eTextile/Synth/refs/publications/MOCO17-MusicSkin.pdf

# Musical Skin

## Fabric Interface for Expressive Music Control

## Maurin Donneaud

DataPaulee, France
maurin@datapaulee.org

## Cedric Honnet

DataPaulee, France
cedric@datapaulee.org

## Paul Strohmeier

HCC, University of Copenhagen, DK p.strohmeier@di.ku.dk

### ABSTRACT

We demonstrate a so, malleable fabric contoller. Aendees can use it to explore sounds, collaboratively create soundscapes and music. is so input device - Musical Skin - senses where it is touched and how much pressure is exerted on it. is is done using a method consisting entirely of fabric components. Using this textile matrix sensor, the performer’s role is changed from that of manipulating a rigid device to engaging with a malleable material. e sensor pushes the performer to explore how the motion of their body map to the sound, changing not only the performers experience but also engaging the audience beyond what typical electronic musical input devices would. In this extended abstract, we discuss the sensing mechanism and describe the installation we envision the musical skin to be used in.

### CCS CONCEPTS

- Human-centered computing → User interface toolkits ; • Applied computing → Sound and music computing ; Media arts ;

### KEYWORDS

Tangible Interfaces, Embodied Interaction, Musical Interface, e-Textile, So Circuits, On-Body Interaction

ACM Reference format:
Maurin Donneaud, Cedric Honnet, and Paul Strohmeier. 2017. Musical Skin. In Proceedings of International Conference on Movement and Computing, London, United Kingdom, June 2017 (MOCO’17), 2 pages.

### 1 INTRODUCTION

We present an installation using Musical Skins: fabric interfaces that users can freely manipulate to play music [2]. If draped over the body, interesting feedback modalities emerge. e users feel the tactile properties of the fabric in their ngertips, while at the same time feeling the pressure and taps of the ngers through their body. Additionally percussive hits, tones and pads ll the room with sound, leading to a multisensory experience involving the entire body. is fabric sensor is hand made (see gure 2), and designed for musical expression and aesthetics, explicitly opting for a playfull approach to technology over devices that turn us into productivity machines. Musical Skins can take on dierent roles, such as a drum kit to create distinct beats and one-shot sounds by

Permission to make digital or hard copies of part or all of this work for personal or classroom use is granted without fee provided that copies are not made or distributed for prot or commercial advantage and that copies bear this notice and the full citation on the rst page. Copyrights for third-party components of this work must be honored. For all other uses, contact the owner/author(s).
MOCO’17, London, United Kingdom
© 2017 Copyright held by the owner/author(s).

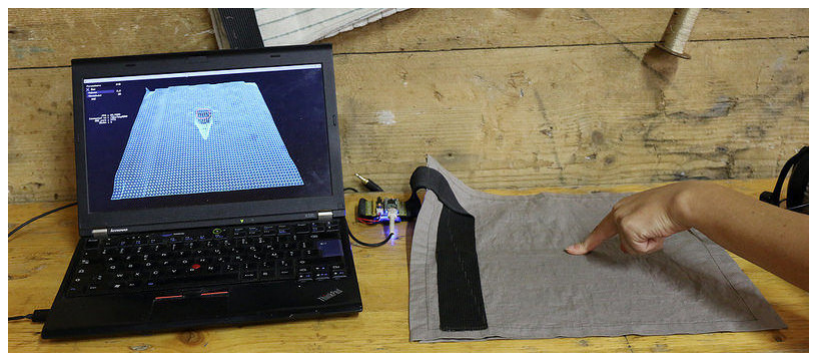
[picture p11: figure]

Figure 1: Visualization of the Musical Skin being touched.

tapping it, or a lead instrument to play modulated melodies on it, or polyphonic device for exploring harmonies, and soundscapes. Dierent instruments will be accessible to the visitors during the exhibit. As the sensor is very robust, no special training or instruction is required for participants.

### 2 RELATED WORK

Electronic textiles have recently received a signicant amount of attention with project Jacquard, however e-textiles and so circuitry have a much longer history. For example, Joanna Berzowska presented e-textile fashion in 2004 [1], her dresses retained a ’memory’ of intimate experiences of the wearer. Hannah Perner Wilson published an overview of so fabric sensors in 2009 [5] and along with Mika Satomi, they maintain an archive of electronic textile experimentations 1
. Similar resistive sensing solutions to ours are used as rapid-prototyping methods. Some of these methods have been documented by David Holman [4]. We use a layering technique demonstrated by Rachel Freire [3]. Our musical skins add additional expressive modalities over typical keyed input devices. is has also been explored by others, such as Seabord 2

, Linnstrument 3 or
Lambdoma 4

### 3 IMPLEMENTATION

is textile sensor was designed with open source, collaborative and DIY development in mind (see gure 2). e hardware and soware designs are freely available and documented at hp://eTextile.org.

### 3.1 Hardware

3.1.1 Textiles. e sensor consists of a grid of vertical and horizontal conductive textile strips (see gure 3), separated by a piezoelectric fabric. When the material is touched, the piezoelectrical

1hp://kobakant.at/DIY
2hp://www.needforkeys.com/blog/the-seaboard-grand-redening-the-keyboard 3hp://www.rogerlinndesign.com/linnstrument.html 4hp://www.lambdoma.com/keyboard.php

MOCO’17, June 2017, London, United Kingdom | Donneaud, Honnet and Strohmeier

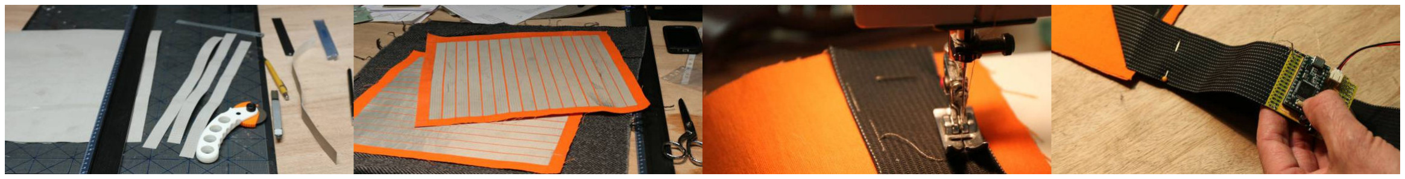
[picture p12: figure]

Figure 2: Steps to create the conductive layers and connect them to the microcontroller.

material is compressed, decreasing its resistance. e conductive fabric used is made by Stratex 5 but there are more aordable alternatives available. e piezoresistive textile used for now is made by Eeonyx 6
and has a resistance of 20K ohms per square. While the material is relatively expensive, it allows for detailed measurement range and a fairly good power consumption compared to other available resistive materials such as Velostat 7

3.1.2 Electronics. A simple voltage divider allows measuring this resistance, but we need a matrix to measure all the possible pressure points. is is done by sequentially pulling each power line high, and measured the voltage by column, in a nested loop. Figure 3 shows an overview of how a 4 x 4 variable resistor matrix is connected (note that our system has a 16 x 16 resolution).

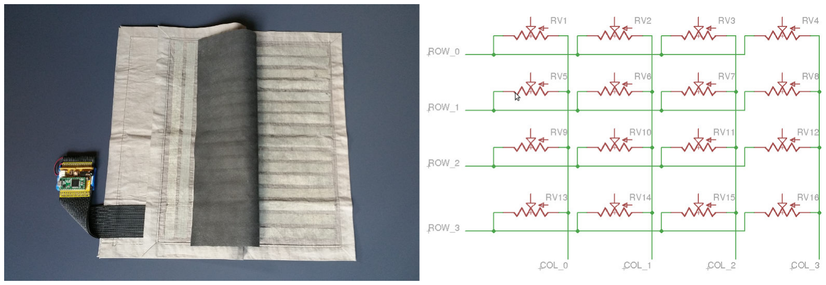
[picture p13: figure]

Figure 3: Le: the vertical and horizontal stripes of conductive fabric, and the resistive fabric in the middle (dark grey). Right: Illustration of a part of the variable ”resistor” matrix.

### 3.2 Soware

3.2.1 Microcontroller. We use a Teensy 3.X 8
to sample the voltages of the sensor. e noise oor is subtracted and the data is normalized, then sent as packets to a computer. Additionally, we use the analog output of the Teensy to allow generating audio without a computer (the board embeds everything needed to work on rechargeable baery).

3.2.2 Computer. When connected to a computer, the data is processed by a program made with OpenFrameworks.cc. We use blob detection algorithms from OpenCV.org to detect the size and locations of touch points. To improve the blob detection, we interpolate the data from 16 x 16 to 64 x 64. As we get a continuous pressure measure, this interpolation improves the resulting touch localization. Each blob’s center and pressure level is then sent to other applications using the OSC protocol. is enables the Musical

5hp://statex.de
6hp://eeonyx.com
7hp://www.lessemf.com/plastic.html 8hp://pjrc.com/teensy

Skin to control music applications 9 or interactive visualizations as will be demonstrated during the exhibition.

### 4 DEMO

e installation can be adopted to the constraints and opportunities of the space available to us. Visitors will discover that dierent instruments require dierent input behavior. e so malleable nature of the controller allows for interesting explorations not possible with conventional interfaces [2]. For example, while a single touch typically would trigger a single sound or drum hit, if the instrument is folded, visitors can create custom polyphonic soundscapes. Finally, this music controller allows to use our bodies
- or the bodies of others - as instruments: we can amplify body percussion with additional sounds, or we can hug each other to create soundscapes. As such expressive on-body input is novel, we believe that our demonstration will provide visitors with a valuable opportunity to improve their intuitive understanding of such technologies.

### 5 CONCLUSION

We propose an installation consisting of Musical Skins which can be used by visitors to control the environment in the form of adapting sound. e primary intent of the fabric instruments is for collaboratively making music while exploring shapes, materiality and bodies. is can be done by draping the fabric over objects, folding and deforming the fabric, or wearing it on the body. e e-textile itself is open source and improves over similar sensing applications both in terms of robustness and resolution.

### 6 ACKNOWLEDGMENT

is paper is based on a project by Maurin Donneaud [2] that dates back to 2005. is paper was supported by the European Research Council, grant no. 648785.

### REFERENCES

[1] Joanna Berzowska. 2004. Very Slowly Animating Textiles: Shimmering Flower. In ACM SIGGRAPH 2004 Sketches (SIGGRAPH ’04). ACM.
[2] Maurin Donneaud, Cedric Honnet, and Paul Strohmeier. 2017. Designing a Multi-Touch eTextile for Music Performances. In Proceedings of the 17th International Conference on New Interfaces for Musical Expression (NIME ’17).
[3] Rachel Freire, Cedric Honnet, and Paul Strohmeier. 2017. Second Skin: An Exploration of eTextile Stretch Circuits on the Body. In Proceedings of the Eleventh International Conference on Tangible, Embedded, and Embodied Interaction (TEI ’17). ACM, New York, NY, USA. DOI:hp://dx.doi.org/10.1145/3024969.3025054
[4] David Holman and Roel Vertegaal. 2011. TactileTape: Low-cost Touch Sensing on Curved Surfaces. In Proceedings of the 24th Annual ACM Symposium Adjunct on User Interface Soware and Technology (UIST ’11 Adjunct). ACM, 17–18.
[5] Hannah Perner-Wilson and Leah Buechley. 2010. Making Textile Sensors from Scratch. Proceedings of the Fourth International Conference on Tangible, Embedded, and Embodied Interaction (2010), 349–352.

9Available on hp://github.com/eTextile/Skins
