eTextile/Synth/docs/assets/img/synth_gitHub.png

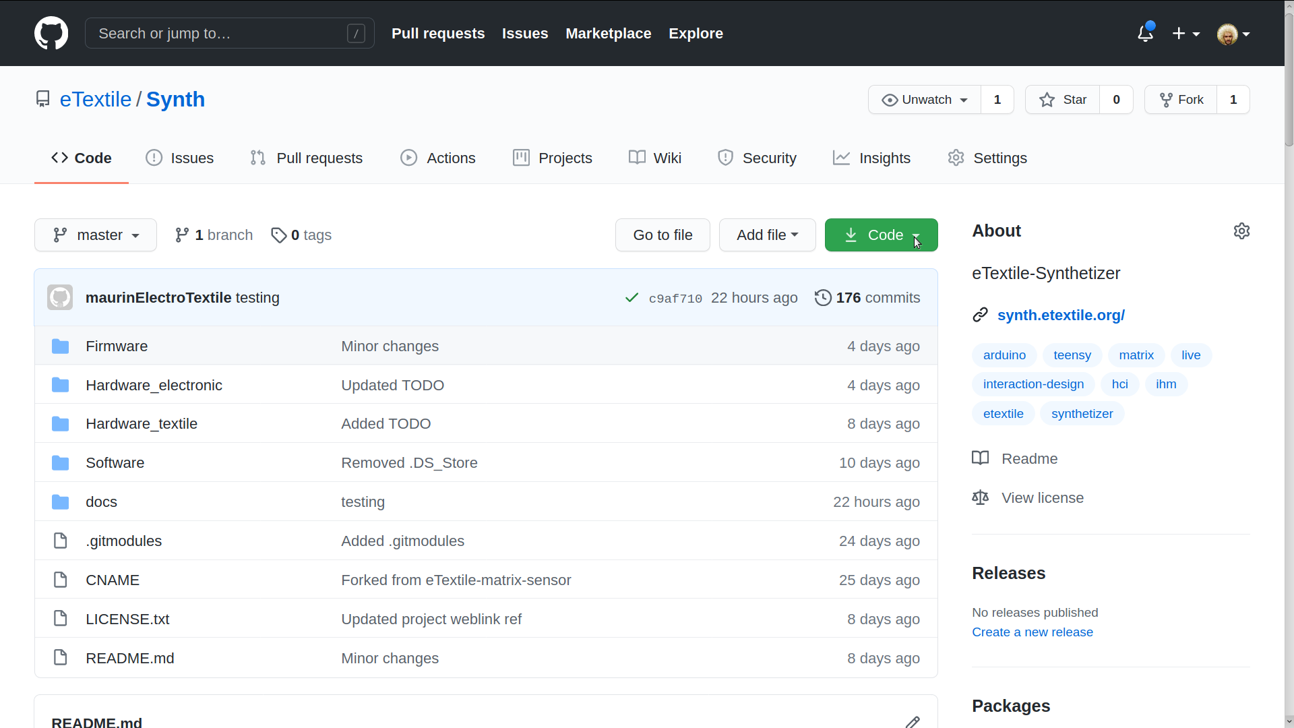
docs/assets/img/synth_gitHub.png
