eTextile/Synth/Hardware_electronic/docs/6N138.png

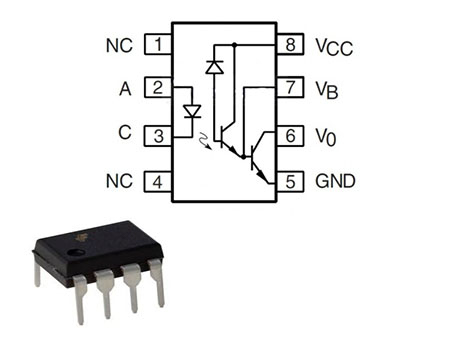
Hardware_electronic/docs/6N138.png
