eTextile/Synth/Hardware_textile/score_Johannes-Itten/800px-Farbkreis_Itten_1961.png

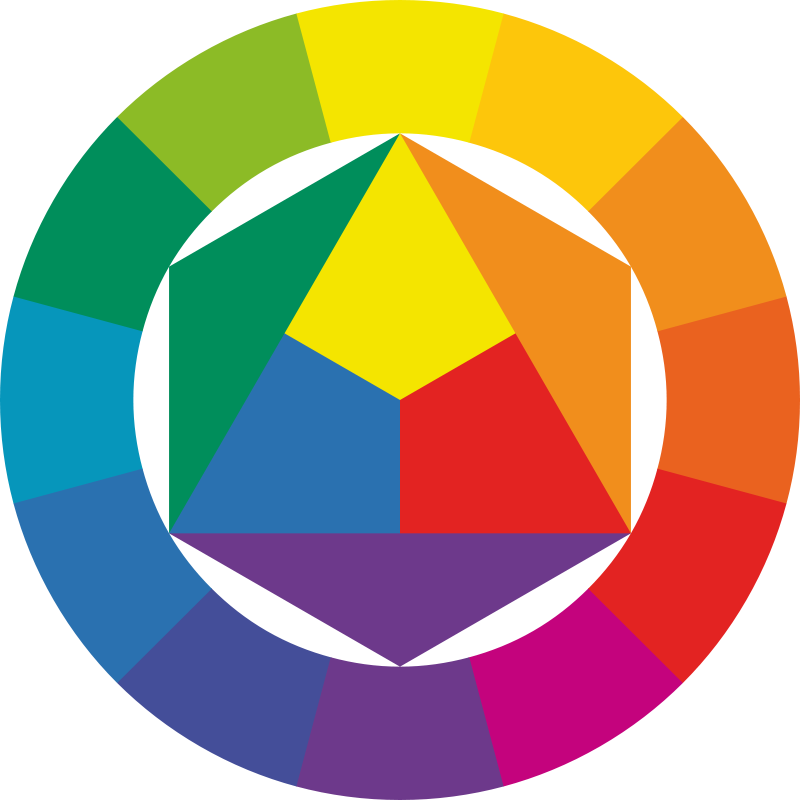
Hardware_textile/score_Johannes-Itten/800px-Farbkreis_Itten_1961.png
