eTextile/Synth/Hardware_electronic/docs/E256_LOGO.dxf

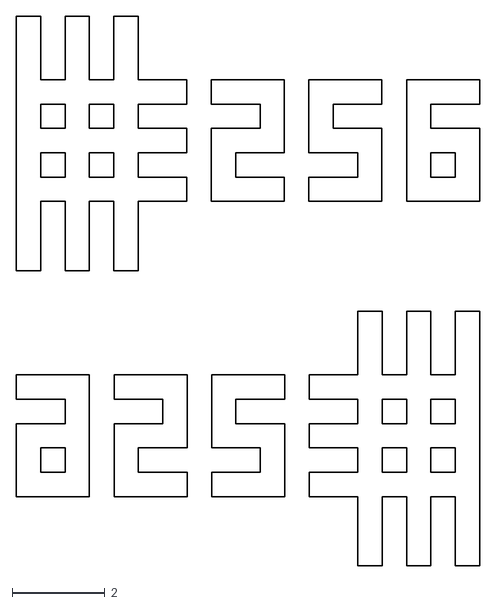
[picture p32: CAD file, 2021-01-04]
Hardware_electronic/docs/E256_LOGO.dxf
9.96 x 11.8
