eTextile/Synth/Hardware_electronic/kicad/e256_teensy4_0/docs/E256_truth_table.dxf

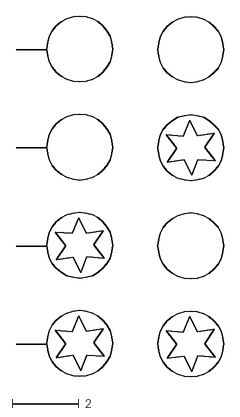
[picture p33: CAD file, 2021-01-04]
Hardware_electronic/kicad/e256_teensy4_0/docs/E256_truth_table.dxf
6.20 x 10.8
