eTextile/Synth/Hardware_electronic/kicad/e256_teensy4_0/docs/E256_polarity.dxf

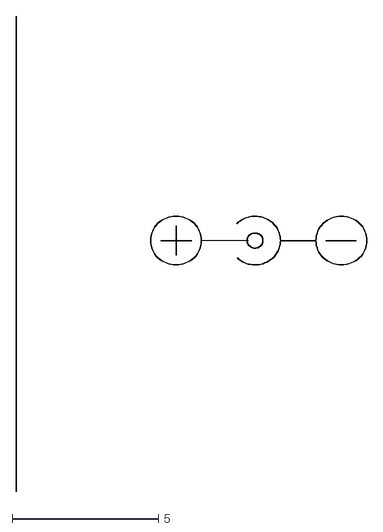
[picture p34: CAD file, 2021-01-04]
Hardware_electronic/kicad/e256_teensy4_0/docs/E256_polarity.dxf
12.0 x 16.3
