eTextile/Synth/Hardware_electronic/kicad/e256_teensy4_0/e256_teensy4_0.kicad_pcb

## KiCad design Hardware_electronic/kicad/e256_teensy4_0/e256_teensy4_0.kicad_pcb (2026-05-15)

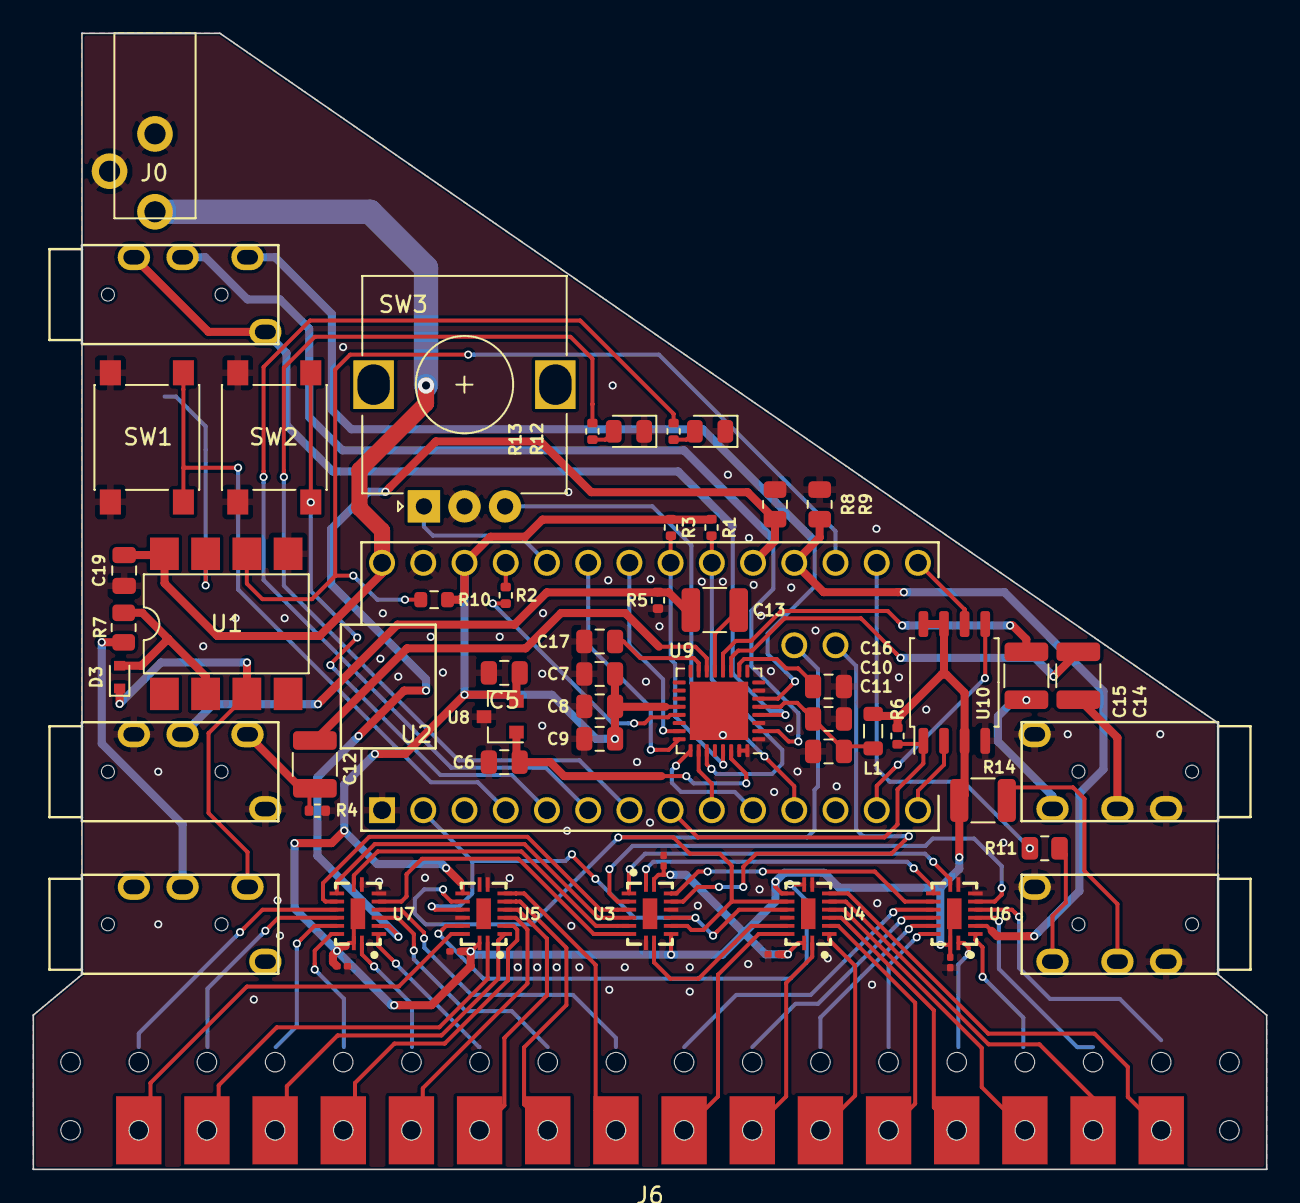
[picture p39: board e256_teensy4_0.kicad_pcb from above]

Board: 2 copper layers, 76.0 x 70.0 mm, 58 parts (1 on the bottom side), 93 nets.

Parts:
C1, C2, C3, C4, C18: 0.1uF 6.3V X5R; C_0201_0603Metric
C5, C6: 2.2uF_X7R; C_0805_2012Metric
C7, C10: 2.2uF; C_0805_2012Metric
C8, C9, C11, C16, C17, C19: 0.1uF; C_0805_2012Metric
C12, C13, C14, C15: 1uF; C_1210_3225Metric
D1, D2: LED; LED_0805_2012Metric
D3: 1N4148; D_SOD-523
J0: Conn_Coaxial_Power; BarrelJack-SMT-DC003_Horizontal
J1: MIDI_IN; PJ-320A
J2: MIDI_OUT; PJ-320A
J3: AUDIO_IN; PJ-320A
J4: AUDIO_OUT; PJ-320A
J5: LINE_OUT; PJ-320A
J6: e256_pad_16x16; e256_pad_16X16
L1: 600R; L_0805_2012Metric
R1, R3: 2.2K; R_0402_1005Metric
R2: 100R; R_0402_1005Metric
R4, R5: 100k; R_0402_1005Metric
R6: 10K; R_0402_1005Metric
R7: 220 Ohm; R_0805_2012Metric
R8, R9: 10K; R_0805_2012Metric
R10: 470 Ohm; R_0603_1608Metric
R11: 47 Ohm 1/8W; R_0805_2012Metric
R12, R13: 100 Ohm; R_0402_1005Metric
R14: 47 Ohm 1/3W; R_1210_3225Metric
R15: 10K; R_0805_2012Metric_Pad1.20x1.40mm_HandSolder
SW1, SW2: SW_Push; SW_SPST_PTS645
SW3: RotaryEncoder_Switch; RotaryEncoder_Alps_EC12E_Vertical_H20mm
U1: 6N138SM; 6N138SM_8-SMD
U2: Teensy4.0; Teensy40
U3, U4, U5: 74HC595BQ; DHVQFN-16-2.5X3.5MM
U6, U7: 74HC4051BQ; DHVQFN-16-2.5X3.5MM
U8: MCP1811A; SOT-23
U9: SGTL5000; QFN-32-1EP_5x5mm_P0.5mm_EP3.6x3.6mm
U10: W25Q128JVS; SOIC-8_5.23x5.23mm_P1.27mm

Connections:
+1V8: C6.1, U8.1, U9.30
+5V: C19.1, J0.1, U1.8, U2.33
/SGTL5000/filter_audio_3v3: C10.1, C11.1, L1.2, U9.5
ANALOG_0: R9.1, U2.23, U6.3
ANALOG_1: R8.1, U2.24, U7.3
BCLK: U2.28, U9.24
COL_0: J6.16, U4.7
COL_1: J6.17, U4.6
COL_2: J6.18, U4.5
COL_3: J6.19, U4.4
COL_4: J6.20, U4.3
COL_5: J6.21, U4.2
COL_6: J6.22, U4.1
COL_7: J6.23, U4.15
COL_8: J6.24, U5.7
COL_9: J6.25, U5.6
COL_10: J6.26, U5.5
COL_11: J6.27, U5.4
COL_12: J6.28, U5.3
COL_13: J6.29, U5.2
COL_14: J6.30, U5.1
COL_15: J6.31, U5.15
DS_B: U3.9, U4.14
DS_C: U4.9, U5.14
ENCODER_A: SW3.A, U2.29
ENCODER_B: SW3.B, U2.11
EN_A: U3.3, U6.6
EN_B: U3.7, U7.6
GND: C1.2, C2.2, C3.2, C4.2, C5.2, C6.2, C7.2, C8.2, C9.2, C10.2, C11.2, C16.2, C17.2, C18.2, C19.2, D1.1, D2.1, J0.2, J2.R2, J2.S, J3.R2, J3.S, J4.R2, J4.S, R4.1, R5.1, R8.2, R9.2, R15.2, SW1.2, SW2.2, SW3.C, U1.5, U2.1, U2.32, U3.8, U3.13, U4.8, U4.13, U5.8, U5.13, U6.7, U6.8, U7.7, U7.8, U8.3, U9.1, U9.3, U9.7, U9.31, U9.32, U9.33, U10.4
I2C_SCL_0: R3.2, U2.26, U9.29
I2C_SDA_0: R1.2, U2.25, U9.27
I2S_IN: U2.10, U9.25
I2S_OUT: U2.9, U9.26
LED_1: R12.1, U2.6
LED_2: R13.1, U2.7
LRCLK: U2.27, U9.23
MCLK: R2.2, U2.30
MEM_CS: R6.2, U2.8, U10.1
MEM_MISO: U2.14, U10.2
MEM_MOSI: U2.13, U10.5
MEM_SCK: U2.20, U10.6
MIDI_IN: R10.2, U1.6, U2.22
MIDI_OUT: R11.2, U2.21
unnamed: C12.1, U9.14
unnamed: C12.2, J3.T, R4.2
unnamed: C13.1, U9.13
unnamed: C13.2, J3.R1, R5.2
unnamed: C14.1, U9.11
unnamed: C14.2, J4.R1
unnamed: C15.1, U9.12
unnamed: C15.2, J4.T
unnamed: C16.1, U9.10
unnamed: C17.1, U9.15
unnamed: D1.2, R13.2
unnamed: D2.2, R12.2
unnamed: D3.1, J1.T, U1.3
unnamed: D3.2, R7.1, U1.2
unnamed: J1.R1, R7.2
unnamed: J2.R1, R14.2
unnamed: J2.T, R11.1
unnamed: J5.R1, U9.2
unnamed: J5.R2, J5.S, U9.4
unnamed: J5.T, U9.6
unnamed: R2.1, U9.21
unnamed: R15.1, U1.7
ROW_0: J6.0, U6.5
ROW_1: J6.1, U6.4
ROW_2: J6.2, U6.2
ROW_3: J6.3, U6.1
ROW_4: J6.4, U6.15
ROW_5: J6.5, U6.14
ROW_6: J6.6, U6.13
ROW_7: J6.7, U6.12
ROW_8: J6.8, U7.5
ROW_9: J6.9, U7.4
ROW_10: J6.10, U7.2
ROW_11: J6.11, U7.1
ROW_12: J6.12, U7.15
ROW_13: J6.13, U7.14
ROW_14: J6.14, U7.13
ROW_15: J6.15, U7.12
S0_A: U3.15, U6.11
S0_B: U3.4, U7.11
S1_A: U3.1, U6.10
S1_B: U3.5, U7.10
S2_A: U3.2, U6.9
S2_B: U3.6, U7.9
SHIFT_OUT_CS: U2.2, U3.12, U4.12, U5.12
SHIFT_OUT_MOSI: U2.37, U3.14
SHIFT_OUT_SCK: U2.38, U3.11, U4.11, U5.11
SWITCH_A: SW1.1, U2.4
SWITCH_B: SW2.1, U2.5
VCC: C1.1, C2.1, C3.1, C4.1, C5.1, C7.1, C8.1, C9.1, C18.1, L1.1, R1.1, R3.1, R6.1, R10.1, R14.1, U2.31, U3.10, U3.16, U4.10, U4.16, U5.10, U5.16, U6.16, U6.EP, U7.16, U7.EP, U8.2, U9.20, U10.3, U10.7, U10.8
