eTextile/Synth/Firmware/src/config.cpp

/*
  This file is part of the eTextile-Synthesizer project - https://synth.eTextile.org
  Copyright (c) 2014- Maurin Donneaud <maurin@etextile.org>
  This work is licensed under Creative Commons Attribution-ShareAlike 4.0 International license, see the LICENSE file for details.
*/

#include <ArduinoJson.h>
#include <SerialFlash.h>
#include <Bounce2.h>

#include "config.h"
#include "scan.h"
#include "interp.h"
#include "usb_midi_io.h"
#include "hardware_midi_io.h"
#include "allocate.h"
#include "mapping.h"

#include "mapp_switch.h"
#include "mapp_slider.h"
#include "mapp_touchpad.h"
#include "mapp_knob.h"
#include "mapp_polygon.h"
#include "mapp_grid.h"

Bounce BUTTON_L = Bounce();
Bounce BUTTON_R = Bounce();

const char* get_mode_name(mode_code_t code) {
  const char* char_code = NULL;
  switch (code) {
    case PENDING_MODE: char_code = "PENDING_MODE"; break;
    case SYNC_MODE: char_code = "SYNC_MODE"; break;
    case CALIBRATE_MODE: char_code = "CALIBRATE_MODE"; break;
    case MATRIX_RAW_MODE: char_code = "MATRIX_RAW_MODE"; break;
    case MATRIX_INTERP_MODE: char_code = "MATRIX_INTERP_MODE"; break;
    case MAPPING_MODE: char_code = "MAPPING_MODE"; break;
    case EDIT_MODE: char_code = "EDIT_MODE"; break;
    case THROUGH_MODE: char_code = "THROUGH_MODE"; break;
    case PLAY_MODE: char_code = "PLAY_MODE"; break;
    case ALLOCATE_MODE: char_code = "ALLOCATE_MODE"; break;
    case UPLOAD_MODE: char_code = "UPLOAD_MODE"; break;
    case APPLY_MODE: char_code = "APPLY_MODE"; break;
    case WRITE_MODE: char_code = "WRITE_MODE"; break;
    case LOAD_MODE: char_code = "LOAD_MODE"; break;
    case FETCH_MODE: char_code = "FETCH_MODE"; break;
    case STANDALONE_MODE: char_code = "STANDALONE_MODE"; break;
    case USB_INTERFACE_MODE: char_code = "USB_INTERFACE_MODE"; break;
    case ERROR_MODE: char_code = "ERROR_MODE"; break;
    case BOOTLOADER_MODE: char_code = "BOOTLOADER_MODE"; break;
  }
  return char_code;
};

const char* get_verbosity_name(verbosity_code_t code) {
  const char* char_code = NULL;
  switch (code) {
    case PENDING_MODE_DONE: char_code = "PENDING_MODE_DONE"; break;
    case SYNC_MODE_DONE: char_code = "SYNC_MODE_DONE"; break;
    case CALIBRATE_MODE_DONE: char_code = "CALIBRATE_MODE_DONE"; break;
    case MATRIX_RAW_MODE_DONE: char_code = "MATRIX_RAW_MODE_DONE"; break;
    case MATRIX_INTERP_MODE_DONE: char_code = "MATRIX_INTERP_MODE_DONE"; break;
    case MAPPING_MODE_DONE: char_code = "MAPPING_MODE_DONE"; break;
    case EDIT_MODE_DONE: char_code = "EDIT_MODE_DONE"; break;
    case THROUGH_MODE_DONE: char_code = "THROUGH_MODE_DONE"; break;
    case PLAY_MODE_DONE: char_code = "PLAY_MODE_DONE"; break;
    case ALLOCATE_MODE_DONE: char_code = "ALLOCATE_MODE_DONE"; break;
    case ALLOCATE_DONE: char_code = "ALLOCATE_DONE"; break;
    case UPLOAD_MODE_DONE: char_code = "UPLOAD_MODE_DONE"; break;
    case UPLOAD_DONE: char_code = "UPLOAD_MODE_DONE"; break;
    case CONFIG_APPLY_DONE: char_code = "CONFIG_APPLY_DONE"; break;
    case WRITE_MODE_DONE: char_code = "WRITE_MODE_DONE"; break;
    case LOAD_MODE_DONE: char_code = "LOAD_MODE_DONE"; break;
    case FETCH_MODE_DONE: char_code = "FETCH_MODE_DONE"; break;
    case STANDALONE_MODE_DONE: char_code = "STANDALONE_MODE_DONE"; break;
    case USB_INTERFACE_MODE_DONE: char_code = "USB_INTERFACE_MODE_DONE"; break;
    case DONE_ACTION: char_code = "DONE_ACTION"; break;
  }
  return char_code;
};

const char* get_level_name(level_code_t code) {
  const char* char_code = NULL;
  switch (code) {
    case THRESHOLD: char_code = "THRESHOLD"; break;
    case SIG_IN: char_code = "SIG_IN"; break;
    case SIG_OUT: char_code = "SIG_OUT"; break;
    case LINE_OUT: char_code = "LINE_OUT"; break;
  }
  return char_code;
};

const char* get_error_name(error_code_t code) {
  const char* char_code = NULL;
  switch (code) {
    case CONFIG_FILE_MISSING: char_code = "CONFIG_FILE_MISSING"; break;
    case CONNECTING_FLASH: char_code = "CONNECTING_FLASH"; break;
    case FLASH_FULL: char_code = "FLASH_FULL"; break;
    case FILE_TO_BIG: char_code = "FILE_TO_BIG"; break;
    case NO_CONFIG_FILE: char_code = "NO_CONFIG_FILE"; break;
    case WHILE_OPEN_FLASH_FILE: char_code = "WHILE_OPEN_FLASH_FILE"; break;
    case USBMIDI_CONFIG_LOAD_FAILED: char_code = "USBMIDI_CONFIG_LOAD_FAILED"; break;
    case FLASH_CONFIG_LOAD_FAILED: char_code = "FLASH_CONFIG_LOAD_FAILED"; break;
    case FLASH_CONFIG_WRITE_FAILED: char_code = "FLASH_CONFIG_WRITE_FAILED"; break;
    case CONFIG_APPLY_FAILED: char_code = "CONFIG_APPLY_FAILED"; break;
    case UNKNOWN_SYSEX: char_code = "UNKNOWN_SYSEX"; break;
    case TOO_MANY_BLOBS: char_code = "TOO_MANY_BLOBS"; break;
    case TOO_MANY_TOUCHS: char_code = "TOO_MANY_TOUCHS"; break;
  }
  return char_code;
};

e256_mode_t e256_m[19] = {
  {{HIGH, LOW, false}, 50, 50, true},     // [0] PENDING_MODE
  {{HIGH, LOW, false}, 500, 500, true},   // [1] SYNC_MODE
  {{HIGH, LOW, false}, 15, 15, true},     // [2] CALIBRATE_MODE
  {{HIGH, HIGH, false}, 200, 200, true},  // [3] MATRIX_RAW_MODE
  {{HIGH, HIGH, false}, 400, 400, true},  // [4] MATRIX_INTERP_MODE
  {{HIGH, HIGH, false}, 500, 500, true},  // [5] MAPPING_MODE
  {{HIGH, LOW, false}, 1000, 50, true},   // [6] EDIT_MODE
  {{HIGH, LOW, false}, 1500, 500, true},  // [7] THROUGH_MODE
  {{HIGH, LOW, false}, 50, 1000, true},   // [8] PLAY_MODE
  {{HIGH, LOW, false}, 1000, 1000, true}, // [9] ALLOCATE_MODE
  {{HIGH, LOW, false}, 1000, 1000, true}, // [10] UPLOAD_MODE
  {{HIGH, LOW, false}, 1000, 1000, true}, // [11] APPLY_MODE
  {{HIGH, LOW, false}, 1000, 1000, true}, // [12] WRITE_MODE
  {{HIGH, LOW, false}, 1000, 1000, true}, // [13] LOAD_MODE
  {{HIGH, LOW, false}, 1000, 1000, true}, // [14] FETCH_MODE
  {{LOW, HIGH, false}, 2000, 2000, true}, // [15] STANDALONE_MODE
  {{LOW, HIGH, false}, 100, 100, true},   // [16] USB_INTERFACE_MODE
  {{HIGH, HIGH, false}, 5, 5, true},      // [17] ERROR_MODE
  {{HIGH, HIGH, false}, 100, 100, true}  // [18] BOOTLOADER_MODE
};


// The E256 built-in encoder is used to adjust levels
Encoder e256_e(ENCODER_PIN_A, ENCODER_PIN_B);

// The levels below can be selected using E256 built-in right switche
level_t e256_l[4] = {
  {{HIGH, HIGH, false}, 2, 50, 2, false},  // [0] THRESHOLD
  {{HIGH, LOW, false}, 1, 31, 17, false},  // [1] SIG_IN
  {{LOW, HIGH, false}, 13, 31, 29, false}, // [2] SIG_OUT
  {{LOW, LOW, false}, 2, 60, 3, false}     // [3] LINE_OUT
};

control_t e256_ctr = {
  &e256_e,    // encoder_ptr
  &e256_m[0], // modes_ptr
  &e256_l[0]  // levels_ptr
};

mode_code_t e256_current_mode = PENDING_MODE;
level_code_t e256_current_level = THRESHOLD;

verbosity_code_t e256_verbosity_code;
error_code_t e256_error_code;

uint8_t* flash_config_ptr = NULL;
size_t flash_config_size = 0;

// Her it should not compile if you didn't install the library
// [Bounce2]: https://github.com/thomasfredericks/Bounce2
// https://www.pjrc.com/teensy/interrupts.html
// https://github.com/khoih-prog/Teensy_TimerInterrupt/blob/main/examples/SwitchDebounce/SwitchDebounce.ino
static void setup_buttons(void) {
  BUTTON_L.attach(BUTTON_PIN_L, INPUT_PULLUP);  // Attach the debouncer to a pin with INPUT_PULLUP mode
  BUTTON_R.attach(BUTTON_PIN_R, INPUT_PULLUP);  // Attach the debouncer to a pin with INPUT_PULLUP mode
  BUTTON_L.interval(25);                        // Debounce interval of 25 millis
  BUTTON_R.interval(25);                        // Debounce interval of 25 millis
};

void setup_leds(void* ptr) {
  leds_t* leds_ptr = (leds_t*)ptr;
  pinMode(LED_PIN_D1, OUTPUT);
  pinMode(LED_PIN_D2, OUTPUT);
  digitalWrite(LED_PIN_D1, leds_ptr->D1);
  digitalWrite(LED_PIN_D2, leds_ptr->D2);
};

void blink(uint8_t iter, uint16_t delay_time) {
  for (uint8_t i = 0; i<iter; i++){
    digitalWrite(LED_PIN_D1, HIGH);
    digitalWrite(LED_PIN_D2, HIGH);
    delay(delay_time);
    digitalWrite(LED_PIN_D1, LOW);
    digitalWrite(LED_PIN_D2, LOW);
    delay(delay_time);
  }
};

void set_mode(mode_code_t mode) {
  e256_ctr.modes[(uint8_t)e256_current_mode].leds.update = false;
  e256_ctr.levels[(uint8_t)e256_current_level].leds.update = false;
  setup_leds(&e256_ctr.modes[(uint8_t)mode]);
  e256_ctr.modes[(uint8_t)mode].leds.update = true;
  //e256_last_mode = e256_current_mode;
  e256_current_mode = mode;
  #if defined(USB_MIDI_SERIAL) && defined(DEBUG_MODES)
    Serial.printf("\nMODE:\t%s", get_mode_name(mode));
  #endif
};

void set_level(level_code_t level, uint8_t value) {
  e256_ctr.modes[(uint8_t)e256_current_mode].leds.update = false;
  e256_ctr.encoder->write(value << 2);
  setup_leds(&e256_ctr.levels[(uint8_t)level]);
  e256_ctr.levels[(uint8_t)level].update = true;
  e256_current_level = level;
  #if defined(USB_MIDI_SERIAL) && defined(DEBUG_LEVELS)
    Serial.printf("\n%s:\t%d", get_level_name(level), value);
  #endif
};

static bool flash_file(const char* fileName, uint8_t* data_ptr, uint16_t size) {
  if (sysEx_data_length != 0) {
    SerialFlash.wakeup();
    while (!SerialFlash.ready());
    if (SerialFlash.exists(fileName)) {
      SerialFlash.remove(fileName);
    }
    // Create a new file and open it for writing
    SerialFlashFile tmpFile;
    if (SerialFlash.create(fileName, size)) {
      tmpFile = SerialFlash.open(fileName);
      if (!tmpFile){
        usb_midi_send_sysex_err((uint8_t)WHILE_OPEN_FLASH_FILE);
        return false;
      }
    }
    else {
      usb_midi_send_sysex_err((uint8_t)FLASH_FULL);
      return false;
    }
    if (sysEx_data_length < FLASH_CHIP_SIZE) {
      tmpFile.write(data_ptr, size);
      tmpFile.close();
      SerialFlash.sleep();
      return true;
    }
    else {
      usb_midi_send_sysex_err((uint8_t)FILE_TO_BIG);
      return false;
    }
  }
  return false;
};

// Selec the current mode and perform the matrix sensor calibration 
static void update_buttons(void) {
  BUTTON_L.update();
  BUTTON_R.update();
  // ACTION: BUTTON_L short pressure
  // FONCTION: CALIBRATE THE SENSOR MATRIX
  if (BUTTON_L.rose() && BUTTON_L.previousDuration() < LONG_HOLD) {
    matrix_calibrate();
    blink(10, 50);
  }

  // ACTION: BUTTON_L long pressure
  // FONCTION: save the mapping config file to the permanent flash memory
  if (BUTTON_L.rose() && BUTTON_L.previousDuration() > LONG_HOLD) {
    if (e256_current_mode == STANDALONE_MODE) return;
    if (sysEx_data_length > 0) {
      if (flash_file("config.json", sysEx_data_ptr, sysEx_data_length)){
        usb_midi_send_sysex_ack((uint8_t)WRITE_MODE_DONE);
      }
      else {
        usb_midi_send_sysex_err((uint8_t)FLASH_CONFIG_WRITE_FAILED);
        //set_mode(ERROR_MODE);
      }
    }
  }

  // ACTION: BUTTON_R long pressure
  // FONCTION: PENDING_MODE (waiting for mode)
  // LEDs: blink slowly (500ms) alternately
  if (BUTTON_R.rose() && BUTTON_R.previousDuration() > LONG_HOLD) {
    set_mode(PENDING_MODE);
    boot_time = millis();
  }

  // ACTION: BUTTON_R short pressure
  // FONCTION: SELECT_LEVEL
  // levels[0] = THRESHOLD
  // levels[1] = SIG_IN
  // levels[2] = SIG_OUT
  // levels[3] = LINE_OUT
  if (BUTTON_R.rose() && BUTTON_R.previousDuration() < LONG_HOLD) {
    uint8_t tmp_level = (((uint8_t)e256_current_level) + 1) % 4; // Loop into level modes
    set_level((level_code_t)tmp_level, e256_ctr.levels[tmp_level].val);
  }
};

static void setup_encoder(void) {
  e256_ctr.encoder->write(e256_ctr.levels[(uint8_t)e256_current_level].val << 2);
}

// Levels values adjustment using rotary encoder
static bool read_encoder(level_code_t level) {
  level_t* lev = &e256_ctr.levels[(uint8_t)level];
  int32_t raw = e256_ctr.encoder->read() >> 2; // signed: goes negative when turning CCW below 0
  uint8_t val;
  if (raw < (int32_t)lev->min_val) {
    e256_ctr.encoder->write((int32_t)lev->min_val << 2);
    val = lev->min_val;
  }
  else if (raw > (int32_t)lev->max_val) {
    e256_ctr.encoder->write((int32_t)lev->max_val << 2);
    val = lev->max_val;
  }
  else {
    val = (uint8_t)raw;
  }
  if (val == lev->val) return false;
  lev->val = val;
  lev->leds.update = true;
  if (e256_current_mode != STANDALONE_MODE)
    usb_midi_send_sysex_param((uint8_t)level, val);
  return true;
};

// Update levels[level] of each mode using the rotary encoder
static void update_encoder(void) {
  static uint32_t level_time_stamp = 0;
  static bool level_toggle = false;

  if (read_encoder(e256_current_level)) {
    level_toggle = true;
    set_level(e256_current_level, e256_ctr.levels[e256_current_level].val);
    level_time_stamp = millis();
  }
  else if (millis() - level_time_stamp > LEVEL_TIMEOUT && level_toggle) {
    level_toggle = false;
    e256_current_level = THRESHOLD;
    set_mode(e256_current_mode);
  }
};

static void blink_leds(uint8_t mode) {
  static uint32_t ledsTimeStamp = 0;

  if (e256_ctr.modes[mode].leds.update) {
    if (millis() - ledsTimeStamp < e256_ctr.modes[mode].timeOn && e256_ctr.modes[mode].toggle == true ) {
      e256_ctr.modes[mode].toggle = false;
      digitalWrite(LED_PIN_D1, e256_ctr.modes[mode].leds.D1);
      digitalWrite(LED_PIN_D2, e256_ctr.modes[mode].leds.D2);
    }
    else if (millis() - ledsTimeStamp > e256_ctr.modes[mode].timeOn && e256_ctr.modes[mode].toggle == false) {
      e256_ctr.modes[mode].toggle = true;
      digitalWrite(LED_PIN_D1, !e256_ctr.modes[mode].leds.D1);
      digitalWrite(LED_PIN_D2, !e256_ctr.modes[mode].leds.D2);
    }
    else if (millis() - ledsTimeStamp > e256_ctr.modes[mode].timeOn + e256_ctr.modes[mode].timeOff) {
    ledsTimeStamp = millis();
    }
  }
};

static void fade_leds(level_code_t level) {
  if (e256_ctr.levels[(uint8_t)level].leds.update) {
    e256_ctr.levels[(uint8_t)level].leds.update = false;
    uint8_t ledVal = constrain(map(e256_ctr.levels[(uint8_t)level].val, e256_ctr.levels[(uint8_t)level].min_val, e256_ctr.levels[(uint8_t)level].max_val, 0, 255), 0, 255);
    analogWrite(LED_PIN_D1, abs(255 - ledVal));
    analogWrite(LED_PIN_D2, ledVal);
  }
};

// Update LEDs according to the mode and rotary encoder values
static void update_leds() {
  blink_leds((uint8_t)e256_current_mode);
  fade_leds(e256_current_level);
};

/////////////////////////////////////////////////////
// LOAD CONFIG PARAMS FROM JSON FILE
/////////////////////////////////////////////////////

static bool config_load_mappings_switchs(const JsonArray &config) {
  if (config.isNull()) {
    return false;
  }
  uint8_t n = config.size();
  if (mapping_switchs_alloc(n)) {
    for (uint8_t i = 0; i < n; i++) {
      mapping_switch_create(config[i]);
    }
    return true;
  }
  return false;
};

static bool config_load_mappings_sliders(const JsonArray& config) {
  if (config.isNull()) {
    return false;
  }
  uint8_t n = config.size();
  if (mapping_sliders_alloc(n)) {
    for (uint8_t i = 0; i < n; i++) {
      mapping_slider_create(config[i]);
    }
    return true;
  }
  return false;
};

static bool config_load_mappings_knobs(const JsonArray& config) {
  if (config.isNull()) {
    return false;
  }
  uint8_t n = config.size();
  if (mapping_knobs_alloc(n)) {
    for (uint8_t i = 0; i < n; i++) {
      mapping_knob_create(config[i]);
    }
    return true;
  }
  return false;
};

static bool config_load_mappings_touchpads(const JsonArray& config) {
  if (config.isNull()) {
    return false;
  }
  uint8_t n = config.size();
  if (mapping_touchpads_alloc(n)) {
    for (uint8_t i = 0; i < n; i++) {
      mapping_touchpad_create(config[i]);
    }
    return true;
  }
  return false;
};

static bool config_load_mappings_polygons(const JsonArray& config) {
  if (config.isNull()) {
    return false;
  };
  uint8_t n = config.size();
  if (mapping_polygons_alloc(n)) {
    for (uint8_t i = 0; i < n; i++) {
      mapping_polygon_create(config[i]);
    }
    return true;
  }
  return false;
};

static bool config_load_mappings_grids(const JsonArray& config) {
  if (config.isNull()) {
    return false;
  }
  uint8_t n = config.size();
  if (mapping_grids_alloc(n)) {
    for (uint8_t i = 0; i < n; i++) {
      mapping_grid_create(config[i]);
    }
    return true;
  }
  return false;
};

bool mappings_load_config(const JsonObject config) {
  if (config.isNull()) {
    //usb_midi_send_info((uint8_t)CONFIG_FILE_IS_NULL, MIDI_ERROR_CHANNEL);
    return false;
  }
  while (llist_pop_front(&llist_mappings) != NULL) {}
  if (!config_load_mappings_switchs(config["switch"])) {
    //Serial.println("CONFIG_LOAD_SWITCHS: FAILD");
  }
  if (!config_load_mappings_sliders(config["slider"])) {
    //Serial.println("CONFIG_LOAD_SLIDERS: FAILD");
  }
  if (!config_load_mappings_knobs(config["knob"])) {
    //Serial.println("CONFIG_LOAD_KNOBS: FAILD");
  }
  if (!config_load_mappings_touchpads(config["touchpad"])) {
    //Serial.println("CONFIG_LOAD_TOUCHPADS: FAILD");
  }
  if (!config_load_mappings_polygons(config["polygon"])) {
    //Serial.println("CONFIG_LOAD_POLYGONS: FAILD");
  }
  if (!config_load_mappings_grids(config["grid"])) {
    //Serial.println("CONFIG_LOAD_GRIDS: FAILD");
  }
  return true;
};

bool mappings_apply_config(uint8_t* conf_ptr, size_t conf_size) {
  JsonDocument e256_config;
  DeserializationError error = deserializeJson(e256_config, conf_ptr, conf_size);
  if (error) {
    #if defined(USB_MIDI_SERIAL) && defined(DEBUG_CONFIG)
      Serial.printf("\nDESERIALIZATION_ERROR:\t%s", error.c_str());
    #endif
    return false;
  }
  if (mappings_load_config(e256_config["mappings"])) {
    return true;
  }
  else {
    return false;
  }
};

static void setup_serial_flash(void) {
  if (!SerialFlash.begin(FLASH_CHIP_SELECT)) {
    if (e256_current_mode != STANDALONE_MODE) {
      usb_midi_send_sysex_err((uint8_t)CONNECTING_FLASH);
    }
  }
  else {
    SerialFlash.sleep();
  }
};

bool load_flash_config(void) {
  SerialFlash.wakeup();
  while (!SerialFlash.ready());
  if (SerialFlash.exists("config.json")) {
    SerialFlashFile configFile = SerialFlash.open("config.json");
    flash_config_size = configFile.size();
    flash_config_ptr = (uint8_t*)allocate(flash_config_ptr, flash_config_size);
    configFile.read(flash_config_ptr, flash_config_size);
    configFile.close();
    SerialFlash.sleep();
    return true;
  }
  else {
    return false;
  }
};

void hardware_setup(void) {
  pinMode(LED_PIN_D1, OUTPUT);
  pinMode(LED_PIN_D2, OUTPUT);
  setup_buttons();
  setup_encoder();
  setup_serial_flash();
};

void update_controls(void) {
  update_buttons();
  update_encoder();
  update_leds();
};
