eTextile/Synth/Software/openFrameworks/SYNTH_MIDI/src/main.cpp

// =============================================================================
//
// Copyright (c) 2014-2016 Christopher Baker <http://christopherbaker.net>
//
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
// =============================================================================

#include "ofMain.h"
#include "ofApp.h"

//========================================================================
int main( )
{

    // ofSetupOpenGL(1024,768, OF_FULLSCREEN); // BUG when moving o an other application
    ofSetupOpenGL( 1024, 768, OF_WINDOW );
    // this kicks off the running of my app
    // can be OF_WINDOW or OF_FULLSCREEN
    // pass in width and height too:
    ofRunApp( new ofApp() );
}
