eTextile/Synth/Firmware/src/mapp_slider.cpp

/*
  This file is part of the eTextile-Synthesizer project - https://synth.eTextile.org
  Copyright (c) 2014- Maurin Donneaud <maurin@etextile.org>
  This work is licensed under Creative Commons Attribution-ShareAlike 4.0 International license, see the LICENSE file for details.
*/

#include "mapp_slider.h"
#include "usb_midi_io.h"

typedef struct mapp_slider_s mapp_slider_t;
struct mapp_slider_s {
  common_t common;
  slider_t params;
  uint8_t active_blob_count;
  uint8_t slot_mask; // bitmask of occupied touch slots — bit i set means touch[i] is in use
  llist_t llist_active_midi_msg;
  uint8_t active_midi_msg_count;
  midi_msg_t note_off_msgs[MAX_SLIDER_TOUCHS];
};

static mapp_slider_t mapp_sliders[MAX_SLIDERS];

llist_t llist_sliders_pool;

// Initialises the slider pool with sliders_cnt nodes carved from the static array.
// Must be called once at boot before any mapping_slider_create() calls.
// Returns false if sliders_cnt exceeds MAX_SLIDERS.
bool mapping_sliders_alloc(uint8_t sliders_cnt) {
  if (sliders_cnt <= MAX_SLIDERS) {
    llist_builder(&llist_sliders_pool, &mapp_sliders[0], sliders_cnt, sizeof(mapp_sliders[0]));
    return true;
  }
  return false;
};

// Returns true if the blob centroid falls strictly inside the slider bounding rectangle.
bool mapping_slider_is_blob_inside(void* mapping_ptr, blob_t* blob_ptr) {
  mapp_slider_t* slider_ptr = (mapp_slider_t*)mapping_ptr;

  if (blob_ptr->centroid.x > slider_ptr->params.rect.from.x &&
      blob_ptr->centroid.x < slider_ptr->params.rect.to.x &&
      blob_ptr->centroid.y > slider_ptr->params.rect.from.y &&
      blob_ptr->centroid.y < slider_ptr->params.rect.to.y) {
    return true;
  }
  return false;
};

// Claims the next free touch slot for this blob.
// Returns false when all configured touch slots are already occupied.
// Assigns the first free slot (first clear bit in slot_mask) so freed slots are recycled
// immediately — a lifted-and-replaced finger always gets a valid slot.
bool mapping_slider_assign_blob(void* mapping_ptr, blob_t* blob_ptr) {
  mapp_slider_t* slider_ptr = (mapp_slider_t*)mapping_ptr;

  for (uint8_t i = 0; i < slider_ptr->params.touchs; i++) {
    if (!(slider_ptr->slot_mask & (1 << i))) {
      blob_ptr->action.mapping_ptr = slider_ptr;
      blob_ptr->action.touch_ptr = &slider_ptr->params.touch[i];
      blob_ptr->action.touch_slot = i;
      slider_ptr->slot_mask |= (1 << i);
      slider_ptr->active_blob_count++;
      return true;
    }
  }
  return false;
};

void mapping_slider_dispose_blob(void* mapping_ptr, blob_t* blob_ptr) {
  mapp_slider_t* slider_ptr = (mapp_slider_t*)mapping_ptr;

  uint8_t slot = (uint8_t)((touch_linear_t*)blob_ptr->action.touch_ptr - slider_ptr->params.touch);
  blob_ptr->action.mapping_ptr = NULL;
  blob_ptr->action.touch_ptr = NULL;
  blob_ptr->action.touch_slot = TOUCH_SLOT_NONE;
  slider_ptr->slot_mask &= ~(1 << slot);
  slider_ptr->active_blob_count--;
};

// Called on the first frame a blob is detected inside the slider (status == NEW).
// For MOVE_ROL + NoteOn: defers via xy velocity — fires once lateral movement is detected
//   so the velocity reflects actual slide speed (not a stationary press artifact).
// For non-ROL NoteOn: defers via z-attack velocity (mapping_send_midi_note_on handles pending).
// For other press types: fires the MIDI press message immediately.
void mapping_slider_start(blob_t* blob_ptr) {
  mapp_slider_t* slider_ptr = (mapp_slider_t*)blob_ptr->action.mapping_ptr;
  touch_linear_t* touch_ptr = (touch_linear_t*)blob_ptr->action.touch_ptr;

  if (slider_ptr->params.move == MOVE_ROL && slider_ptr->params.steps > 0) {
    uint8_t step_idx;
    if (slider_ptr->params.dir == VERTICAL) {
      step_idx = (uint8_t)map(blob_ptr->centroid.y,
        slider_ptr->params.rect.from.y, slider_ptr->params.rect.to.y,
        0, slider_ptr->params.steps - 1);
    } else {
      step_idx = (uint8_t)map(blob_ptr->centroid.x,
        slider_ptr->params.rect.from.x, slider_ptr->params.rect.to.x,
        0, slider_ptr->params.steps - 1);
    }
    step_idx = constrain(step_idx, 0, slider_ptr->params.steps - 1);
    touch_ptr->press.msg.data1 = slider_ptr->params.step_note[step_idx];
  }

  if (touch_ptr->press.enabled) {
    if (touch_ptr->press.msg.type == NoteOn) {
      if (slider_ptr->params.move == MOVE_ROL) {
        blob_ptr->action.note_on_xy_pending = true;
      } else {
        mapping_send_midi_note_on(&touch_ptr->press, blob_ptr);
      }
    } else {
      mapping_send_midi_msg_press(&touch_ptr->press, blob_ptr);
    }
  }
};

// Called every frame while the blob remains inside the slider (status == PRESENT).
// For MOVE_ROL: sends NoteOff/NoteOn pairs on step boundary crossings; if the initial
// NoteOn is still pending, retargets the deferred note without sending a NoteOff.
// For other move modes: streams continuous position (CC/aftertouch) along the
// slider axis (X for HORIZONTAL, Y for VERTICAL) plus optional pressure.
void mapping_slider_continue(blob_t* blob_ptr) {
  mapp_slider_t* slider_ptr = (mapp_slider_t*)blob_ptr->action.mapping_ptr;
  touch_linear_t* touch_ptr = (touch_linear_t*)blob_ptr->action.touch_ptr;

  if (slider_ptr->params.move == MOVE_ROL && slider_ptr->params.steps > 0) {
    uint8_t step_idx;
    if (slider_ptr->params.dir == VERTICAL) {
      step_idx = (uint8_t)map(blob_ptr->centroid.y,
        slider_ptr->params.rect.from.y, slider_ptr->params.rect.to.y,
        0, slider_ptr->params.steps - 1);
    } else {
      step_idx = (uint8_t)map(blob_ptr->centroid.x,
        slider_ptr->params.rect.from.x, slider_ptr->params.rect.to.x,
        0, slider_ptr->params.steps - 1);
    }
    step_idx = constrain(step_idx, 0, slider_ptr->params.steps - 1);
    uint8_t new_note = slider_ptr->params.step_note[step_idx];
    if (new_note != touch_ptr->press.msg.data1) {
      if (blob_ptr->action.note_on_z_pending || blob_ptr->action.note_on_xy_pending) {
        touch_ptr->press.msg.data1 = new_note; // retarget deferred NoteOn, no NoteOff to send yet
      } else {
        uint8_t touch_idx = (uint8_t)(touch_ptr - slider_ptr->params.touch); // pointer diff → index of touch_ptr in params.touch[]
        slider_ptr->note_off_msgs[touch_idx] = touch_ptr->press.msg;
        slider_ptr->note_off_msgs[touch_idx].type = NoteOff;
        slider_ptr->note_off_msgs[touch_idx].data2 = 0;
        llist_push_front(&llist_midi_out, &slider_ptr->note_off_msgs[touch_idx]);
        touch_ptr->press.msg.data1 = new_note;
        mapping_send_midi_note_on_xy(&touch_ptr->press, blob_ptr);
      }
    }
  }
  else {
    if (slider_ptr->params.dir == HORIZONTAL) {
      mapping_send_midi_msg_pos_x(&slider_ptr->params.rect, &touch_ptr->pos, blob_ptr, slider_ptr->params.move);
    }
    else {
      rect_t rect_inv = slider_ptr->params.rect;
      rect_inv.from.y = slider_ptr->params.rect.to.y;
      rect_inv.to.y   = slider_ptr->params.rect.from.y;
      mapping_send_midi_msg_pos_y(&rect_inv, &touch_ptr->pos, blob_ptr, slider_ptr->params.move);
    }
    const MidiType _pt = touch_ptr->press.msg.type;
    if (_pt == ControlChange || _pt == AfterTouchPoly) {
      mapping_send_midi_msg_press(&touch_ptr->press, blob_ptr);
    }
  }
  mapping_send_midi_msg_speed(&touch_ptr->speed, blob_ptr);
};

// Called when the blob leaves the slider or is lost (status == RELEASED).
// For NoteOn press mode: if the initial NoteOn was never sent (still pending), cancels
// the deferred flag; otherwise sends NoteOff for the currently playing note.
// Other press types tail off naturally.
void mapping_slider_stop(blob_t* blob_ptr) {
  touch_linear_t* touch_ptr = (touch_linear_t*)blob_ptr->action.touch_ptr;
  if (touch_ptr->press.enabled && touch_ptr->press.msg.type == NoteOn) {
    if (blob_ptr->action.note_on_z_pending || blob_ptr->action.note_on_xy_pending) {
      blob_ptr->action.note_on_z_pending = false;
      blob_ptr->action.note_on_xy_pending = false;
    } else {
      mapping_send_midi_note_off(&touch_ptr->press);
    }
  }
};

// Returns true if the incoming hardware MIDI message is on the slider's input channel,
// qualifying it for step-note population via mapping_slider_hardware_midi_update().
bool mapping_slider_hardware_midi_receive(void* mapping_ptr, midi_msg_t* midi_msg_ptr) {
  mapp_slider_t* slider_ptr = (mapp_slider_t*)mapping_ptr;
  if (midi_msg_ptr->channel == slider_ptr->params.chan_in) {
    return true;
  }
  return false;
};

// Populates the slider's step_note table from a hardware MIDI NoteOn received on chan_in.
// Each populate mode distributes the incoming notes differently across the step array:
//   POPULATE_AS_PLAYED  — fills steps in arrival order (wraps around).
//   POPULATE_UP         — re-sorts all held notes ascending after each new arrival.
//   POPULATE_DOWN       — re-sorts all held notes descending after each new arrival.
//   POPULATE_OCTAVE     — fills steps with a chromatic run starting from the received note.
//   POPULATE_PING_PONG  — bounces the fill position back and forth across the step range.
void mapping_slider_hardware_midi_update(void* mapping_ptr, midi_msg_t* midi_msg_ptr) {
  mapp_slider_t* slider_ptr = (mapp_slider_t*)mapping_ptr;
  llist_push_front(&slider_ptr->llist_active_midi_msg, midi_msg_ptr);
  slider_ptr->active_midi_msg_count++;

  uint8_t steps = slider_ptr->params.steps;
  if (steps == 0) return;

  switch (slider_ptr->params.populate) {

    case POPULATE_OFF:
      break;
    case POPULATE_AS_PLAYED: {
      uint8_t zone = (slider_ptr->active_midi_msg_count - 1) % steps;
      slider_ptr->params.step_note[zone] = midi_msg_ptr->data1;
      break;
    }
    case POPULATE_UP: {
      uint8_t notes[MAX_SLIDER_STEPS] = {0};
      uint8_t count = 0;
      for (lnode_t* node = ITERATOR_START_FROM_HEAD(&slider_ptr->llist_active_midi_msg);
           node != NULL && count < steps;
           node = ITERATOR_NEXT(node), count++) {
        notes[count] = ((midi_msg_t*)ITERATOR_DATA(node))->data1;
      }
      for (uint8_t a = 0; a < count - 1; a++) {
        for (uint8_t b = 0; b < count - 1 - a; b++) {
          if (notes[b] > notes[b + 1]) { uint8_t t = notes[b]; notes[b] = notes[b+1]; notes[b+1] = t; }
        }
      }
      for (uint8_t i = 0; i < count; i++) {
        slider_ptr->params.step_note[i] = notes[i];
      }
      break;
    }
    case POPULATE_DOWN: {
      uint8_t notes[MAX_SLIDER_STEPS] = {0};
      uint8_t count = 0;
      for (lnode_t* node = ITERATOR_START_FROM_HEAD(&slider_ptr->llist_active_midi_msg);
           node != NULL && count < steps;
           node = ITERATOR_NEXT(node), count++) {
        notes[count] = ((midi_msg_t*)ITERATOR_DATA(node))->data1;
      }
      for (uint8_t a = 0; a < count - 1; a++) {
        for (uint8_t b = 0; b < count - 1 - a; b++) {
          if (notes[b] < notes[b + 1]) { uint8_t t = notes[b]; notes[b] = notes[b+1]; notes[b+1] = t; }
        }
      }
      for (uint8_t i = 0; i < count; i++) {
        slider_ptr->params.step_note[i] = notes[i];
      }
      break;
    }
    case POPULATE_OCTAVE: {
      uint8_t base = midi_msg_ptr->data1;
      for (uint8_t i = 0; i < steps; i++) {
        slider_ptr->params.step_note[i] = base + i;
      }
      break;
    }
    case POPULATE_PING_PONG:
      if (steps > 1) {
        uint8_t period = 2 * (steps - 1);
        uint8_t pos = (slider_ptr->active_midi_msg_count - 1) % period;
        uint8_t zone = (pos < steps) ? pos : period - pos;
        slider_ptr->params.step_note[zone] = midi_msg_ptr->data1;
      }
      break;
  }
};

// Called when a hardware MIDI NoteOff is received for a previously tracked note.
// Decrements the active count; when all notes are released the active message list
// is drained and its nodes returned to the shared MIDI pool for reuse.
void mapping_slider_hardware_midi_dispose(void* mapping_ptr, midi_msg_t* midi_msg_ptr) {
  mapp_slider_t* slider_ptr = (mapp_slider_t*)mapping_ptr;
  slider_ptr->active_midi_msg_count--;
  if (slider_ptr->active_midi_msg_count == 0) {
    midi_msg_t* freed_msg = NULL;
    while ((freed_msg = (midi_msg_t*)llist_pop_front(&slider_ptr->llist_active_midi_msg)) != NULL) {
      llist_push_front(&llist_midi_nodes_pool, freed_msg);
    }
  }
};

// Deserialises one slider entry from the JSON config, wires all function pointers,
// and appends the fully configured slider to llist_mappings.
// dir (VERTICAL / HORIZONTAL) is read from the "dir" JSON field when present (0=VERTICAL, 1=HORIZONTAL);
// falls back to bounding-box aspect ratio for configs that predate the explicit dir field.
// step_note[] is pre-filled with a chromatic run starting at MIDI note 60.
void mapping_slider_create(const JsonObject &config) {

  mapp_slider_t* slider_ptr = (mapp_slider_t*)llist_pop_front(&llist_sliders_pool);
  slider_ptr->slot_mask        = 0;
  slider_ptr->active_blob_count = 0;

  slider_ptr->common.hardware_midi_receive_func_ptr = &mapping_slider_hardware_midi_receive;
  slider_ptr->common.hardware_midi_update_func_ptr = &mapping_slider_hardware_midi_update;
  slider_ptr->common.hardware_midi_dispose_func_ptr = &mapping_slider_hardware_midi_dispose;

  slider_ptr->common.is_blob_inside_func_ptr = &mapping_slider_is_blob_inside;
  slider_ptr->common.blob_assign_func_ptr = &mapping_slider_assign_blob;
  slider_ptr->common.blob_dispose_func_ptr = &mapping_slider_dispose_blob;

  slider_ptr->common.start_func_ptr = &mapping_slider_start;
  slider_ptr->common.continue_func_ptr = &mapping_slider_continue;
  slider_ptr->common.stop_func_ptr = &mapping_slider_stop;

  slider_ptr->params.touchs = config["touchs"].as<uint8_t>();
  slider_ptr->params.rect.from.x = config["from"][0].as<float>();
  slider_ptr->params.rect.from.y = config["from"][1].as<float>();
  slider_ptr->params.rect.to.x = config["to"][0].as<float>();
  slider_ptr->params.rect.to.y = config["to"][1].as<float>();
  slider_ptr->params.move = config["move"].as<move_t>();
  slider_ptr->params.populate = config["populate"].as<populate_t>();
  slider_ptr->params.steps = config["steps"].as<uint8_t>();
  slider_ptr->params.chan_in  = config["chan"]["in"].as<uint8_t>();
  slider_ptr->params.chan_out = config["chan"]["out"].as<uint8_t>();

  for (uint8_t i = 0; i < MAX_SLIDER_STEPS; i++) {
    slider_ptr->params.step_note[i] = 60 + i;
  }
  if (slider_ptr->params.touchs <= MAX_SLIDER_TOUCHS) {
    midi_status_t status;

    for (uint8_t i = 0; i<slider_ptr->params.touchs; i++) {

      uint8_t pos_status = config["msg"][i]["pos"]["midi"]["status"].as<uint8_t>();
      midi_msg_status_unpack(pos_status, &status);
      slider_ptr->params.touch[i].pos.enabled     = (pos_status != 0) && (config["msg"][i]["pos"]["enabled"] | true);
      slider_ptr->params.touch[i].pos.msg.type    = status.type;
      slider_ptr->params.touch[i].pos.msg.data1   = config["msg"][i]["pos"]["midi"]["data1"].as<uint8_t>();
      slider_ptr->params.touch[i].pos.msg.data2   = 0;
      slider_ptr->params.touch[i].pos.msg.channel = status.channel;
      slider_ptr->params.touch[i].pos.limit.min   = config["msg"][i]["pos"]["limit"]["min"].as<uint8_t>();
      slider_ptr->params.touch[i].pos.limit.max   = config["msg"][i]["pos"]["limit"]["max"].as<uint8_t>();

      {
        uint8_t press_status = config["msg"][i]["press"]["midi"]["status"].as<uint8_t>();
        if (press_status != 0) {
          midi_msg_status_unpack(press_status, &status);
          slider_ptr->params.touch[i].press.enabled     = config["msg"][i]["press"]["enabled"] | true;
          slider_ptr->params.touch[i].press.msg.type    = status.type;
          slider_ptr->params.touch[i].press.msg.data1   = config["msg"][i]["press"]["midi"]["data1"].as<uint8_t>();
          slider_ptr->params.touch[i].press.msg.data2   = 0;
          slider_ptr->params.touch[i].press.msg.channel = status.channel;
          slider_ptr->params.touch[i].press.limit.min   = config["msg"][i]["press"]["limit"]["min"].as<uint8_t>();
          slider_ptr->params.touch[i].press.limit.max   = config["msg"][i]["press"]["limit"]["max"].as<uint8_t>();
        } else {
          slider_ptr->params.touch[i].press.enabled = false;
        }
      }

      if (config["msg"][i]["speed"].is<JsonObject>()) {
        uint8_t vel_status = config["msg"][i]["speed"]["midi"]["status"].as<uint8_t>();
        midi_msg_status_unpack(vel_status, &status);
        slider_ptr->params.touch[i].speed.enabled     = (vel_status != 0) && (config["msg"][i]["speed"]["enabled"] | true);
        slider_ptr->params.touch[i].speed.msg.type    = ControlChange;
        slider_ptr->params.touch[i].speed.msg.data1   = config["msg"][i]["speed"]["midi"]["data1"].as<uint8_t>();
        slider_ptr->params.touch[i].speed.msg.data2   = 0;
        slider_ptr->params.touch[i].speed.msg.channel = status.channel;
        slider_ptr->params.touch[i].speed.limit.min   = config["msg"][i]["speed"]["limit"]["min"].as<uint8_t>();
        slider_ptr->params.touch[i].speed.limit.max   = config["msg"][i]["speed"]["limit"]["max"].as<uint8_t>();
      } else {
        slider_ptr->params.touch[i].speed.enabled = false;
      }

    }
    if (config["dir"].is<int>()) {
      slider_ptr->params.dir = (dir_t)config["dir"].as<uint8_t>();
    } else {
      uint8_t size_x = (uint8_t)(slider_ptr->params.rect.to.x - slider_ptr->params.rect.from.x);
      uint8_t size_y = (uint8_t)(slider_ptr->params.rect.to.y - slider_ptr->params.rect.from.y);
      slider_ptr->params.dir = (size_x < size_y) ? VERTICAL : HORIZONTAL;
    }
    llist_push_back(&llist_mappings, slider_ptr);
  } else {
    usb_midi_send_sysex_err((uint8_t)TOO_MANY_TOUCHS);
  }
};
