eTextile/Synth/Firmware/src/mapp_knob.cpp

/*
  This file is part of the eTextile-Synthesizer project - https://synth.eTextile.org
  Copyright (c) 2014- Maurin Donneaud <maurin@etextile.org>
  This work is licensed under Creative Commons Attribution-ShareAlike 4.0 International license, see the LICENSE file for details.
*/

#include "mapp_knob.h"
#include "usb_midi_io.h"

typedef struct mapp_knob_s mapp_knob_t;
struct mapp_knob_s {
  common_t common;
  knob_t params;
  uint8_t active_blob_count;
  uint8_t slot_mask; // bitmask of occupied touch slots — bit i set means touch[i] is in use
  llist_t llist_active_midi_msg;
  uint8_t active_midi_msg_count;
  midi_msg_t chord_notes[MAX_KNOB_TOUCHS][MAX_CHORD_NOTES];
};

static mapp_knob_t mapp_knobs[MAX_KNOBS];

llist_t llist_knobs_pool;

bool mapping_knobs_alloc(uint8_t knobs_cnt) {
  if (knobs_cnt <= MAX_KNOBS) {
    llist_builder(&llist_knobs_pool, &mapp_knobs[0], knobs_cnt, sizeof(mapp_knobs[0]));
    return true;
  }
  return false;
};

bool mapping_knob_is_blob_inside(void* mapping_ptr, blob_t* blob_ptr) {
  mapp_knob_t* knob_ptr = (mapp_knob_t*)mapping_ptr;

  float x = blob_ptr->centroid.x - knob_ptr->params.center.x;
  float y = blob_ptr->centroid.y - knob_ptr->params.center.y;
  float radius = sqrt(x * x + y * y);
  if (radius < knob_ptr->params.radius) {
    return true;
  }
  return false;
};

bool mapping_knob_assign_blob(void* mapping_ptr, blob_t* blob_ptr) {
  mapp_knob_t* knob_ptr = (mapp_knob_t*)mapping_ptr;

  for (uint8_t i = 0; i < knob_ptr->params.touchs; i++) {
    if (!(knob_ptr->slot_mask & (1 << i))) {
      blob_ptr->action.mapping_ptr = knob_ptr;
      blob_ptr->action.touch_ptr = &knob_ptr->params.touch[i];
      blob_ptr->action.touch_slot = i;
      knob_ptr->slot_mask |= (1 << i);
      knob_ptr->active_blob_count++;
      return true;
    }
  }
  return false;
};

void mapping_knob_dispose_blob(void* mapping_ptr, blob_t* blob_ptr) {
  mapp_knob_t* knob_ptr = (mapp_knob_t*)mapping_ptr;

  uint8_t slot = (uint8_t)((knob_touch_t*)blob_ptr->action.touch_ptr - knob_ptr->params.touch);
  blob_ptr->action.mapping_ptr = NULL;
  blob_ptr->action.touch_ptr = NULL;
  blob_ptr->action.touch_slot = TOUCH_SLOT_NONE;
  knob_ptr->slot_mask &= ~(1 << slot);
  knob_ptr->active_blob_count--;
};

void mapping_knob_start(blob_t* blob_ptr) {
  mapp_knob_t* knob_ptr = (mapp_knob_t*)blob_ptr->action.mapping_ptr;
  knob_touch_t* touch_ptr = (knob_touch_t*)blob_ptr->action.touch_ptr;

  if (!touch_ptr->press.enabled) return;
  switch (touch_ptr->press.msg.type) {
    case NoteOn:
      mapping_send_midi_note_on(&touch_ptr->press, blob_ptr);
      break;
    case MIDI_TYPE_CHORD_TRIGGER:
    case MIDI_TYPE_CHORD_GATE: {
      if (!touch_ptr->press.enabled) break;
      uint8_t ti = (uint8_t)(touch_ptr - &knob_ptr->params.touch[0]);
      midi_send_chord_on(knob_ptr->chord_notes[ti], &knob_ptr->params.chord[ti],
                         knob_ptr->params.chan_out,
                         (uint8_t)constrain((int)roundf(1.0f + constrain((blob_ptr->centroid.z - Z_MIN) / (float)(Z_MAX - Z_MIN), 0.0f, 1.0f) * 126.0f), 1, 127));
      break;
    }
    default:
      mapping_send_midi_msg_press(&touch_ptr->press, blob_ptr);
      break;
  }
};

void mapping_knob_continue(blob_t* blob_ptr) {
  mapp_knob_t* knob_ptr = (mapp_knob_t*)blob_ptr->action.mapping_ptr;
  knob_touch_t* touch_ptr = (knob_touch_t*)blob_ptr->action.touch_ptr;
  
  //Serial.printf("\n_KNOB_CONTINUE: %s", get_type_name(knob_ptr->params.press));

  float x = blob_ptr->centroid.x - knob_ptr->params.center.x;
  float y = blob_ptr->centroid.y - knob_ptr->params.center.y;

  float theta = 0;
  // Rotation of Axes through an angle without shifting Origin
  float offset_rad = knob_ptr->params.offset * (PI / 180.0f);
  float pos_x = x * cos(offset_rad) + y * sin(offset_rad);
  float pos_y = -x * sin(offset_rad) + y * cos(offset_rad);
  
  if (pos_x == 0 && 0 < pos_y) {
    theta = PI_OVER_2;
  } else if (pos_x == 0 && pos_y < 0) {
    theta = THREE_PI_OVER_2;
  } else if (pos_x < 0) {
    theta = atanf(pos_y / pos_x) + PI;
  } else if (pos_y < 0) {
    theta = atanf(pos_y / pos_x) + TWO_PI;
  } else {
    theta = atanf(pos_y / pos_x);
  }

  touch_ptr->theta.last_val = touch_ptr->theta.msg.data2;

  touch_ptr->theta.msg.data2 = (uint8_t)constrain(
    map(
      (long)round(theta * 1000),
      0,
      (long)round(TWO_PI * 1000),
      touch_ptr->theta.limit.min,
      touch_ptr->theta.limit.max
    ),
    0, 127
  );

  if (touch_ptr->theta.enabled && touch_ptr->theta.msg.data2 != touch_ptr->theta.last_val) {
    if ((millis() - touch_ptr->theta.midi_time_stamp) > MIDI_THROTTLE_MS) {
      llist_push_front(&llist_midi_out, &touch_ptr->theta.msg);
      touch_ptr->theta.midi_time_stamp = millis();
    }
  }

  touch_ptr->radius.last_val = touch_ptr->radius.msg.data2;
  touch_ptr->radius.msg.data2 = (uint8_t)constrain(
    map(
      (long)round(sqrt(x * x + y * y)),
      0,
      (long)round(knob_ptr->params.radius),
      touch_ptr->radius.limit.min,
      touch_ptr->radius.limit.max
    ),
    0, 127
  );

  if (touch_ptr->radius.enabled && touch_ptr->radius.msg.data2 != touch_ptr->radius.last_val) {
    if ((millis() - touch_ptr->radius.midi_time_stamp) > MIDI_THROTTLE_MS) {
      llist_push_front(&llist_midi_out, &touch_ptr->radius.msg);
      touch_ptr->radius.midi_time_stamp = millis();
    }
  }

  const MidiType _pt = touch_ptr->press.msg.type;
  if (_pt == ControlChange || _pt == AfterTouchPoly) {
    mapping_send_midi_msg_press(&touch_ptr->press, blob_ptr);
  }
  mapping_send_midi_msg_speed(&touch_ptr->speed, blob_ptr);

};

void mapping_knob_stop(blob_t* blob_ptr) {
  mapp_knob_t* knob_ptr = (mapp_knob_t*)blob_ptr->action.mapping_ptr;
  knob_touch_t* touch_ptr = (knob_touch_t*)blob_ptr->action.touch_ptr;

  if (!touch_ptr->press.enabled) return;
  switch (touch_ptr->press.msg.type) {
    case NoteOn:
      mapping_send_midi_note_off(&touch_ptr->press);
      break;
    case MIDI_TYPE_CHORD_GATE: {
      if (!touch_ptr->press.enabled) break;
      uint8_t ti = (uint8_t)(touch_ptr - &knob_ptr->params.touch[0]);
      midi_send_chord_off(knob_ptr->chord_notes[ti], knob_ptr->params.chord[ti].type);
      break;
    }
    case MIDI_TYPE_CHORD_TRIGGER:
      break; // trigger-only — no note-off on release
    default:
      break;
  }
};

bool mapping_knob_hardware_midi_receive(void* mapping_ptr, midi_msg_t* midi_msg_ptr) {
  mapp_knob_t* knob_ptr = (mapp_knob_t*)mapping_ptr;
  if (midi_msg_ptr->channel == knob_ptr->params.chan_in) {
    return true;
  }
  return false;
};

void mapping_knob_hardware_midi_update(void* mapping_ptr, midi_msg_t* midi_msg_ptr) {
  mapp_knob_t* knob_ptr = (mapp_knob_t*)mapping_ptr;
  llist_push_front(&knob_ptr->llist_active_midi_msg, midi_msg_ptr);
  knob_ptr->active_midi_msg_count++;
  //...
};

void mapping_knob_hardware_midi_dispose(void* mapping_ptr, midi_msg_t* midi_msg_ptr) {
  mapp_knob_t* knob_ptr = (mapp_knob_t*)mapping_ptr;
  knob_ptr->active_midi_msg_count--;
  if (knob_ptr->active_midi_msg_count == 0) {  // Save/rescue all llist nodes
    midi_msg_t* midi_msg_ptr = NULL;
    while ((midi_msg_ptr = (midi_msg_t*)llist_pop_front(&knob_ptr->llist_active_midi_msg)) != NULL) {
      llist_push_front(&llist_midi_nodes_pool, midi_msg_ptr);
    }
  }
};

void mapping_knob_create(const JsonObject &config) {

  mapp_knob_t* knob_ptr = (mapp_knob_t*)llist_pop_front(&llist_knobs_pool);
  knob_ptr->slot_mask         = 0;
  knob_ptr->active_blob_count = 0;

  knob_ptr->common.hardware_midi_receive_func_ptr = &mapping_knob_hardware_midi_receive;  
  knob_ptr->common.hardware_midi_update_func_ptr = &mapping_knob_hardware_midi_update;  
  knob_ptr->common.hardware_midi_dispose_func_ptr = &mapping_knob_hardware_midi_dispose;

  knob_ptr->common.is_blob_inside_func_ptr = &mapping_knob_is_blob_inside;
  knob_ptr->common.blob_assign_func_ptr = &mapping_knob_assign_blob;
  knob_ptr->common.blob_dispose_func_ptr = &mapping_knob_dispose_blob;
  
  knob_ptr->common.start_func_ptr = &mapping_knob_start;
  knob_ptr->common.continue_func_ptr = &mapping_knob_continue;
  knob_ptr->common.stop_func_ptr = &mapping_knob_stop;
  
  knob_ptr->params.touchs = config["touchs"].as<uint8_t>();
  knob_ptr->params.rect.from.x = config["from"][0].as<float>();
  knob_ptr->params.rect.from.y = config["from"][1].as<float>();
  knob_ptr->params.rect.to.x = config["to"][0].as<float>();
  knob_ptr->params.rect.to.y = config["to"][1].as<float>();
  knob_ptr->params.offset = config["offset"].as<uint8_t>();
  knob_ptr->params.chan_in  = config["chan"]["in"].as<uint8_t>();
  knob_ptr->params.chan_out = config["chan"]["out"].as<uint8_t>();

  if (knob_ptr->params.touchs <= MAX_KNOB_TOUCHS) {

    knob_ptr->params.radius = (knob_ptr->params.rect.to.x - knob_ptr->params.rect.from.x) / 2;
    knob_ptr->params.center.x = (knob_ptr->params.rect.from.x + knob_ptr->params.radius);
    knob_ptr->params.center.y = (knob_ptr->params.rect.from.y + knob_ptr->params.radius);
  
    midi_status_t status;
    for (uint8_t i = 0; i<knob_ptr->params.touchs; i++){
      uint8_t radius_status = config["msg"][i]["radius"]["midi"]["status"].as<uint8_t>();
      midi_msg_status_unpack(radius_status, &status);
      knob_ptr->params.touch[i].radius.enabled     = (radius_status != 0) && (config["msg"][i]["radius"]["enabled"] | true);
      knob_ptr->params.touch[i].radius.msg.type    = status.type;
      knob_ptr->params.touch[i].radius.msg.data1   = config["msg"][i]["radius"]["midi"]["data1"].as<uint8_t>();
      knob_ptr->params.touch[i].radius.msg.data2   = 0;
      knob_ptr->params.touch[i].radius.msg.channel = status.channel;
      knob_ptr->params.touch[i].radius.limit.min   = config["msg"][i]["radius"]["limit"]["min"].as<uint8_t>();
      knob_ptr->params.touch[i].radius.limit.max   = config["msg"][i]["radius"]["limit"]["max"].as<uint8_t>();

      uint8_t theta_status = config["msg"][i]["theta"]["midi"]["status"].as<uint8_t>();
      midi_msg_status_unpack(theta_status, &status);
      knob_ptr->params.touch[i].theta.enabled     = (theta_status != 0) && (config["msg"][i]["theta"]["enabled"] | true);
      knob_ptr->params.touch[i].theta.msg.type    = status.type;
      knob_ptr->params.touch[i].theta.msg.data1   = config["msg"][i]["theta"]["midi"]["data1"].as<uint8_t>();
      knob_ptr->params.touch[i].theta.msg.data2   = 0;
      knob_ptr->params.touch[i].theta.msg.channel = status.channel;
      knob_ptr->params.touch[i].theta.limit.min   = config["msg"][i]["theta"]["limit"]["min"].as<uint8_t>();
      knob_ptr->params.touch[i].theta.limit.max   = config["msg"][i]["theta"]["limit"]["max"].as<uint8_t>();

      if (config["msg"][i]["press"]["chord"].is<JsonVariant>()) {
        knob_ptr->params.chord[i].type = config["msg"][i]["press"]["chord"].as<uint8_t>();
        knob_ptr->params.chord[i].note = config["msg"][i]["press"]["note"].as<uint8_t>();
        knob_ptr->params.touch[i].press.msg.type = config["msg"][i]["press"]["gate"].as<bool>() ? MIDI_TYPE_CHORD_GATE : MIDI_TYPE_CHORD_TRIGGER;
        knob_ptr->params.touch[i].press.enabled  = config["msg"][i]["press"]["enabled"] | true;
      } else {
        uint8_t press_status = config["msg"][i]["press"]["midi"]["status"].as<uint8_t>();
        if (press_status != 0) {
          midi_msg_status_unpack(press_status, &status);
          knob_ptr->params.touch[i].press.enabled     = config["msg"][i]["press"]["enabled"] | true;
          knob_ptr->params.touch[i].press.msg.type    = status.type;
          knob_ptr->params.touch[i].press.msg.data1   = config["msg"][i]["press"]["midi"]["data1"].as<uint8_t>();
          knob_ptr->params.touch[i].press.msg.data2   = 0;
          knob_ptr->params.touch[i].press.msg.channel = status.channel;
          knob_ptr->params.touch[i].press.limit.min   = config["msg"][i]["press"]["limit"]["min"].as<uint8_t>();
          knob_ptr->params.touch[i].press.limit.max   = config["msg"][i]["press"]["limit"]["max"].as<uint8_t>();
        } else {
          knob_ptr->params.touch[i].press.enabled = false;
        }
      }

      if (config["msg"][i]["speed"].is<JsonObject>()) {
        uint8_t vel_status = config["msg"][i]["speed"]["midi"]["status"].as<uint8_t>();
        midi_msg_status_unpack(vel_status, &status);
        knob_ptr->params.touch[i].speed.enabled     = (vel_status != 0) && (config["msg"][i]["speed"]["enabled"] | true);
        knob_ptr->params.touch[i].speed.msg.type    = ControlChange;
        knob_ptr->params.touch[i].speed.msg.data1   = config["msg"][i]["speed"]["midi"]["data1"].as<uint8_t>();
        knob_ptr->params.touch[i].speed.msg.data2   = 0;
        knob_ptr->params.touch[i].speed.msg.channel = status.channel;
        knob_ptr->params.touch[i].speed.limit.min   = config["msg"][i]["speed"]["limit"]["min"].as<uint8_t>();
        knob_ptr->params.touch[i].speed.limit.max   = config["msg"][i]["speed"]["limit"]["max"].as<uint8_t>();
      } else {
        knob_ptr->params.touch[i].speed.enabled = false;
      }
    }
    llist_push_back(&llist_mappings, knob_ptr);
  } else {
    usb_midi_send_sysex_err((uint8_t)TOO_MANY_TOUCHS);
  }
};
