eTextile/Synth/Firmware/src/mapp_switch.cpp

/*
  This file is part of the eTextile-Synthesizer project - https://synth.eTextile.org
  Copyright (c) 2014- Maurin Donneaud <maurin@etextile.org>
  This work is licensed under Creative Commons Attribution-ShareAlike 4.0 International license, see the LICENSE file for details.
*/

#include "mapp_switch.h"
#include "usb_midi_io.h"
#include "midi_tap_tempo.h"

typedef struct mapp_switch_s mapp_switch_t;
struct mapp_switch_s {
  common_t common;
  switch_t params;
  uint8_t active_blob_count;
  uint8_t touch_index;
  llist_t llist_active_midi_msg;
  uint8_t active_midi_msg_count;
  midi_msg_t chord_notes[MAX_SWITCH_TOUCHS][MAX_CHORD_NOTES]; // pre-allocated for chord mode
};

static mapp_switch_t mapp_switches[MAX_SWITCHS];

llist_t llist_switchs_pool;

bool mapping_switchs_alloc(uint8_t switchs_cnt) {
  if (switchs_cnt <= MAX_SWITCHS) {
    llist_builder(&llist_switchs_pool, &mapp_switches[0], switchs_cnt, sizeof(mapp_switches[0]));
    return true;
  }
  return false;
};

// Test if the blob is within the key limit
bool mapping_switch_is_blob_inside(void* mapping_ptr, blob_t* blob_ptr) {
  mapp_switch_t* switch_ptr = (mapp_switch_t*)mapping_ptr;
  
  if (blob_ptr->centroid.x > switch_ptr->params.rect.from.x &&
      blob_ptr->centroid.x < switch_ptr->params.rect.to.x &&
      blob_ptr->centroid.y > switch_ptr->params.rect.from.y &&
      blob_ptr->centroid.y < switch_ptr->params.rect.to.y) {
    return true;
  }
  return false;
};

bool mapping_switch_assign_blob(void* mapping_ptr, blob_t* blob_ptr) {
  mapp_switch_t* switch_ptr = (mapp_switch_t*)mapping_ptr;

  if (switch_ptr->touch_index < switch_ptr->params.touchs) {
    blob_ptr->action.mapping_ptr = switch_ptr;
    blob_ptr->action.touch_ptr = &switch_ptr->params.touch[switch_ptr->touch_index];
    blob_ptr->action.touch_slot = switch_ptr->touch_index;
    switch_ptr->touch_index++;
    switch_ptr->active_blob_count++;
    return true;
  }
  return false;
};

void mapping_switch_dispose_blob(void* mapping_ptr, blob_t* blob_ptr) {
  mapp_switch_t* switch_ptr = (mapp_switch_t*)mapping_ptr;

  blob_ptr->action.mapping_ptr = NULL;
  blob_ptr->action.touch_ptr = NULL;
  blob_ptr->action.touch_slot = TOUCH_SLOT_NONE;
  switch_ptr->active_blob_count--;
  if (switch_ptr->active_blob_count == 0) {
    switch_ptr->touch_index = 0;
  }
};

void mapping_switch_start(blob_t* blob_ptr) {
  mapp_switch_t* switch_ptr = (mapp_switch_t*)blob_ptr->action.mapping_ptr;
  touch_press_t* touch_ptr = (touch_press_t*)blob_ptr->action.touch_ptr;

  if (!touch_ptr->press.enabled) return;
  if (touch_ptr->press.msg.type == Clock) {
    tap_tempo_hit();
    return;
  }

  switch (touch_ptr->press.msg.type) {
    case NoteOn:
      mapping_send_midi_note_on(&touch_ptr->press, blob_ptr);
      break;
    case MIDI_TYPE_CHORD_TRIGGER:
    case MIDI_TYPE_CHORD_GATE: {
      if (!touch_ptr->press.enabled) break;
      uint8_t ti = (uint8_t)(touch_ptr - &switch_ptr->params.touch[0]);
      midi_send_chord_on(switch_ptr->chord_notes[ti], &switch_ptr->params.chord[ti],
                         switch_ptr->params.chan_out,
                         (uint8_t)constrain((int)roundf(1.0f + constrain((blob_ptr->centroid.z - Z_MIN) / (float)(Z_MAX - Z_MIN), 0.0f, 1.0f) * 126.0f), 1, 127));
      break;
    }
    default:
      mapping_send_midi_msg_press(&touch_ptr->press, blob_ptr);
      break;
  }
};

void mapping_switch_continue(blob_t* blob_ptr) {
  touch_press_t* touch_ptr = (touch_press_t*)blob_ptr->action.touch_ptr;

  const MidiType _pt = touch_ptr->press.msg.type;
  if (_pt == ControlChange || _pt == AfterTouchPoly) {
    mapping_send_midi_msg_press(&touch_ptr->press, blob_ptr);
  }
  mapping_send_midi_msg_speed(&touch_ptr->speed, blob_ptr);
};

void mapping_switch_stop(blob_t* blob_ptr) {
  mapp_switch_t* switch_ptr = (mapp_switch_t*)blob_ptr->action.mapping_ptr;
  touch_press_t* touch_ptr = (touch_press_t*)blob_ptr->action.touch_ptr;

  if (!touch_ptr->press.enabled) return;
  switch (touch_ptr->press.msg.type) {
    case NoteOn:
      mapping_send_midi_note_off(&touch_ptr->press);
      break;
    case MIDI_TYPE_CHORD_GATE: {
      if (!touch_ptr->press.enabled) break;
      uint8_t ti = (uint8_t)(touch_ptr - &switch_ptr->params.touch[0]);
      midi_send_chord_off(switch_ptr->chord_notes[ti], switch_ptr->params.chord[ti].type);
      break;
    }
    case MIDI_TYPE_CHORD_TRIGGER:
      break; // trigger-only — no note-off on release
    default:
      break;
  }
};

bool mapping_switch_hardware_midi_receive(void* mapping_ptr, midi_msg_t* midi_msg_ptr) {
  mapp_switch_t* switch_ptr = (mapp_switch_t*)mapping_ptr;
  if (midi_msg_ptr->channel == switch_ptr->params.chan_in) {
    return true;
  }
  return false;
};

void mapping_switch_hardware_midi_update(void* mapping_ptr, midi_msg_t* midi_msg_ptr) {
  mapp_switch_t* switch_ptr = (mapp_switch_t*)mapping_ptr;
  llist_push_front(&switch_ptr->llist_active_midi_msg, midi_msg_ptr);
  switch_ptr->active_midi_msg_count++;
  //...
};

void mapping_switch_hardware_midi_dispose(void* mapping_ptr, midi_msg_t* midi_msg_ptr) {
  mapp_switch_t* switch_ptr = (mapp_switch_t*)mapping_ptr;
  switch_ptr->active_midi_msg_count--;
  if (switch_ptr->active_midi_msg_count == 0) {  // Save/rescue all llist nodes
    midi_msg_t* midi_msg_ptr = NULL;
    while ((midi_msg_ptr = (midi_msg_t*)llist_pop_front(&switch_ptr->llist_active_midi_msg)) != NULL) {
      llist_push_front(&llist_midi_nodes_pool, midi_msg_ptr);
    }
  }
};

void mapping_switch_create(const JsonObject &config) {

  mapp_switch_t* switch_ptr = (mapp_switch_t*)llist_pop_front(&llist_switchs_pool);

  switch_ptr->common.hardware_midi_receive_func_ptr = &mapping_switch_hardware_midi_receive;
  switch_ptr->common.hardware_midi_update_func_ptr = &mapping_switch_hardware_midi_update;
  switch_ptr->common.hardware_midi_dispose_func_ptr = &mapping_switch_hardware_midi_dispose;

  switch_ptr->common.is_blob_inside_func_ptr = &mapping_switch_is_blob_inside;
  switch_ptr->common.blob_assign_func_ptr = &mapping_switch_assign_blob;
  switch_ptr->common.blob_dispose_func_ptr = &mapping_switch_dispose_blob;

  switch_ptr->common.start_func_ptr = &mapping_switch_start;
  switch_ptr->common.continue_func_ptr = &mapping_switch_continue;
  switch_ptr->common.stop_func_ptr = &mapping_switch_stop;
  
  switch_ptr->params.touchs = config["touchs"].as<uint8_t>();
  switch_ptr->params.rect.from.x = config["from"][0].as<float>();
  switch_ptr->params.rect.from.y = config["from"][1].as<float>();
  switch_ptr->params.rect.to.x = config["to"][0].as<float>();
  switch_ptr->params.rect.to.y = config["to"][1].as<float>();
  switch_ptr->params.chan_in  = config["chan"]["in"].as<uint8_t>();
  switch_ptr->params.chan_out = config["chan"]["out"].as<uint8_t>();

  if (switch_ptr->params.touchs <= MAX_SWITCH_TOUCHS) {

    for (uint8_t i = 0; i < switch_ptr->params.touchs; i++) {
      midi_status_t status;
      if (config["msg"][i]["press"]["clock"].as<bool>()) {
        switch_ptr->params.touch[i].press.msg.type = Clock;
        switch_ptr->params.touch[i].press.enabled  = true;
      } else if (config["msg"][i]["press"]["chord"].is<JsonVariant>()) {
        switch_ptr->params.chord[i].type = config["msg"][i]["press"]["chord"].as<uint8_t>();
        switch_ptr->params.chord[i].note = config["msg"][i]["press"]["note"].as<uint8_t>();
        switch_ptr->params.touch[i].press.msg.type = config["msg"][i]["press"]["gate"].as<bool>() ? MIDI_TYPE_CHORD_GATE : MIDI_TYPE_CHORD_TRIGGER;
        switch_ptr->params.touch[i].press.enabled  = config["msg"][i]["press"]["enabled"] | true;
      } else {
        uint8_t press_status = config["msg"][i]["press"]["midi"]["status"].as<uint8_t>();
        if (press_status != 0) {
          midi_msg_status_unpack(press_status, &status);
          switch_ptr->params.touch[i].press.enabled     = config["msg"][i]["press"]["enabled"] | true;
          switch_ptr->params.touch[i].press.msg.type    = status.type;
          switch_ptr->params.touch[i].press.msg.data1   = config["msg"][i]["press"]["midi"]["data1"].as<uint8_t>();
          switch_ptr->params.touch[i].press.msg.data2   = 0;
          switch_ptr->params.touch[i].press.msg.channel = status.channel;
          switch_ptr->params.touch[i].press.limit.min   = config["msg"][i]["press"]["limit"]["min"].as<uint8_t>();
          switch_ptr->params.touch[i].press.limit.max   = config["msg"][i]["press"]["limit"]["max"].as<uint8_t>();
        } else {
          switch_ptr->params.touch[i].press.enabled = false;
        }
      }

      if (config["msg"][i]["speed"].is<JsonObject>()) {
        uint8_t move_status = config["msg"][i]["speed"]["midi"]["status"].as<uint8_t>();
        midi_msg_status_unpack(move_status, &status);
        switch_ptr->params.touch[i].speed.enabled     = (move_status != 0) && (config["msg"][i]["speed"]["enabled"] | true);
        switch_ptr->params.touch[i].speed.msg.type    = ControlChange;
        switch_ptr->params.touch[i].speed.msg.data1   = config["msg"][i]["speed"]["midi"]["data1"].as<uint8_t>();
        switch_ptr->params.touch[i].speed.msg.data2   = 0;
        switch_ptr->params.touch[i].speed.msg.channel = status.channel;
        switch_ptr->params.touch[i].speed.limit.min   = config["msg"][i]["speed"]["limit"]["min"].as<uint8_t>();
        switch_ptr->params.touch[i].speed.limit.max   = config["msg"][i]["speed"]["limit"]["max"].as<uint8_t>();
      } else {
        switch_ptr->params.touch[i].speed.enabled = false;
      }
    }
    llist_push_back(&llist_mappings, switch_ptr);
  } else {
    usb_midi_send_sysex_err((uint8_t)TOO_MANY_TOUCHS);
  }
};
