eTextile/Synth/Firmware/src/mapping.cpp

/*
  This file is part of the eTextile-Synthesizer project - https://synth.eTextile.org
  Copyright (c) 2014- Maurin Donneaud <maurin@etextile.org>
  This work is licensed under Creative Commons Attribution-ShareAlike 4.0 International license, see the LICENSE file for details.
*/

#include "mapping.h"
#include "midi_tap_tempo.h"

llist_t llist_mappings;

static uint32_t frame_now = 0;

static void mapping_flush_pending_note_on_xy(blob_t*);
static void mapping_flush_pending_note_on(blob_t*);

void mapping_lib_update(void) {
  frame_now = millis();
  tap_tempo_clock_tick();

  for (lnode_t* mapping_node_ptr = ITERATOR_START_FROM_HEAD(&llist_mappings); mapping_node_ptr != NULL; mapping_node_ptr = ITERATOR_NEXT(mapping_node_ptr)) {
    common_t* mapping_ptr = (common_t*)ITERATOR_DATA(mapping_node_ptr);
    
    for (lnode_t* blob_node_ptr = ITERATOR_START_FROM_HEAD(&llist_blobs); blob_node_ptr != NULL; blob_node_ptr = ITERATOR_NEXT(blob_node_ptr)) {
      blob_t* blob_ptr = (blob_t*)ITERATOR_DATA(blob_node_ptr);
      common_t* assigned = (common_t*)blob_ptr->action.mapping_ptr;

      if (mapping_ptr->is_blob_inside_func_ptr(mapping_ptr, blob_ptr)) {

        if (assigned == NULL) {
          if (mapping_ptr->blob_assign_func_ptr(mapping_ptr, blob_ptr)) {
            mapping_ptr->start_func_ptr(blob_ptr);
            break;
          }
        }
        else if (assigned == mapping_ptr) {
          if (blob_ptr->status == NEW) {
            mapping_ptr->start_func_ptr(blob_ptr);
          }
          else if (blob_ptr->status == PRESENT) {
            #if defined(BLOB_VELOCITY)
            mapping_flush_pending_note_on(blob_ptr);
            mapping_flush_pending_note_on_xy(blob_ptr);
            #endif
            mapping_ptr->continue_func_ptr(blob_ptr);
          }
          else if (blob_ptr->status == RELEASED && blob_ptr->last_status == MISSING) {
            mapping_ptr->stop_func_ptr(blob_ptr);
          }
        }
      }
      else {
        if (assigned == mapping_ptr) {
          if (blob_ptr->status == RELEASED && blob_ptr->last_status == MISSING) {
            mapping_ptr->stop_func_ptr(blob_ptr);
          }
        }
      }
    }
  }
};

// Sends the deferred NoteOn once attack_done is true.
// touch_press_t / touch_linear_t / touch_planar_t all share press as their first member,
// so a touch_press_t* cast is safe for accessing the press axis regardless of the concrete type.
#if defined(BLOB_VELOCITY)
static void mapping_flush_pending_note_on(blob_t* blob_ptr) {
  if (!blob_ptr->action.note_on_z_pending || !blob_ptr->velocity.attack_done) return;
  if (blob_ptr->action.touch_ptr == NULL) return;
  axis_t* axis_ptr = &((touch_press_t*)blob_ptr->action.touch_ptr)->press;
  axis_ptr->msg.data2 = (uint8_t)constrain((int)(blob_ptr->velocity.attack_z * 127.0f / VELOCITY_ATTACK_Z_MAX), 0, 127);

  llist_push_front(&llist_midi_out, &axis_ptr->msg);
  blob_ptr->action.note_on_z_pending = false;
}

// Sends the deferred NoteOn for ROL sliders using lateral slide velocity.
// Waits until velocity.xy > 0 (finger is actually sliding) so the velocity=0 case
// from a stationary press doesn't produce a NoteOff-disguised NoteOn.
// Falls back after VELOCITY_ATTACK_MAX_MS so a stationary press still triggers a note.
static void mapping_flush_pending_note_on_xy(blob_t* blob_ptr) {
  if (!blob_ptr->action.note_on_xy_pending) return;
  if (blob_ptr->action.touch_ptr == NULL) return;
  uint32_t age = millis() - blob_ptr->velocity.born_at;
  if (blob_ptr->velocity.xy < 1.0f && age < VELOCITY_ATTACK_MAX_MS) return;
  axis_t* axis_ptr = &((touch_press_t*)blob_ptr->action.touch_ptr)->press;
  axis_ptr->msg.data2 = (uint8_t)constrain(max((int)(blob_ptr->velocity.xy * 127.0f / VELOCITY_XY_MAX), 1), 0, 127);

  llist_push_front(&llist_midi_out, &axis_ptr->msg);
  blob_ptr->action.note_on_xy_pending = false;
}
#endif

// Called from every TUI _start when press mode == NoteOn.
// When BLOB_VELOCITY is defined: arms the deferred NoteOn (actual send happens in
// mapping_flush_pending_note_on, called from the PRESENT branch of the dispatcher).
// When BLOB_VELOCITY is not defined: sends immediately using centroid.z as velocity.
void mapping_send_midi_note_on(axis_t* axis_ptr, blob_t* blob_ptr) {
  axis_ptr->msg.type = NoteOn;
#if defined(BLOB_VELOCITY)
  blob_ptr->action.note_on_z_pending = true; // flushed by mapping_flush_pending_note_on()
#else
  float t = constrain((blob_ptr->centroid.z - Z_MIN) / (float)(Z_MAX - Z_MIN), 0.0f, 1.0f);
  axis_ptr->msg.data2 = (uint8_t)roundf(axis_ptr->limit.min + t * (float)(axis_ptr->limit.max - axis_ptr->limit.min));
  llist_push_front(&llist_midi_out, &axis_ptr->msg);
#endif
};

// For MOVE_ROL sliders: velocity comes from lateral sliding speed, not Z attack.
// Sends immediately — no deferred attack window needed for a rolling gesture.
void mapping_send_midi_note_on_xy(axis_t* axis_ptr, blob_t* blob_ptr) {
  axis_ptr->msg.type = NoteOn;
  axis_ptr->msg.data2 = (uint8_t)constrain(max((int)(blob_ptr->velocity.xy * 127.0f / VELOCITY_XY_MAX), 1), 0, 127);
  llist_push_front(&llist_midi_out, &axis_ptr->msg);
  blob_ptr->action.note_on_xy_pending = false; // cancel deferred NoteOn if step changed first
};

void mapping_send_midi_note_off(axis_t* axis_ptr) {
  // NoteOn with velocity 0 == NoteOff (MIDI spec §1.3) — preserves msg.type = NoteOn
  // so the next start event's switch(msg.type) still matches case NoteOn.
  axis_ptr->msg.data2 = 0;
  llist_push_front(&llist_midi_out, &axis_ptr->msg);
};

static inline uint16_t _pos_to_val(axis_t* axis_ptr, float t) {
  if (axis_ptr->msg.type == PitchBend) {
    // 14-bit PitchBend: limit 0-127 scaled to 0-16383 (127 × 129 = 16383)
    uint16_t pb14 = (uint16_t)roundf(
      (float)axis_ptr->limit.min * 129.0f +
      t * ((float)axis_ptr->limit.max - (float)axis_ptr->limit.min) * 129.0f
    );
    axis_ptr->msg.data1 = pb14 & 0x7F;        // LSB
    axis_ptr->msg.data2 = (pb14 >> 7) & 0x7F; // MSB
    return pb14;
  }
  uint8_t v = (uint8_t)roundf(axis_ptr->limit.min + t * (float)(axis_ptr->limit.max - axis_ptr->limit.min));
  axis_ptr->msg.data2 = v;
  return v;
}

void mapping_send_midi_msg_pos_x(rect_t* bounding_box_ptr, axis_t* axis_ptr, blob_t* blob_ptr, move_t move) {
  if (!axis_ptr->enabled) return;
  float t = constrain(
    (blob_ptr->centroid.x - bounding_box_ptr->from.x) /
    (bounding_box_ptr->to.x - bounding_box_ptr->from.x),
    0.0f, 1.0f
  );
  if (move == MOVE_LOG) t = logf(1.0f + t * 1.71828182f);
  uint16_t val = _pos_to_val(axis_ptr, t);
  if (val != axis_ptr->last_val) {
    if ((frame_now - axis_ptr->midi_time_stamp) > MIDI_THROTTLE_MS) {
      llist_push_front(&llist_midi_out, &axis_ptr->msg);
      axis_ptr->last_val = val;
      axis_ptr->midi_time_stamp = frame_now;
    }
  }
};

void mapping_send_midi_msg_pos_y(rect_t* bounding_box_ptr, axis_t* axis_ptr, blob_t* blob_ptr, move_t move) {
  if (!axis_ptr->enabled) return;
  float t = constrain(
    (blob_ptr->centroid.y - bounding_box_ptr->from.y) /
    (bounding_box_ptr->to.y - bounding_box_ptr->from.y),
    0.0f, 1.0f
  );
  if (move == MOVE_LOG) t = logf(1.0f + t * 1.71828182f);
  uint16_t val = _pos_to_val(axis_ptr, t);
  if (val != axis_ptr->last_val) {
    if ((frame_now - axis_ptr->midi_time_stamp) > MIDI_THROTTLE_MS) {
      llist_push_front(&llist_midi_out, &axis_ptr->msg);
      axis_ptr->last_val = val;
      axis_ptr->midi_time_stamp = frame_now;
    }
  }
};

void mapping_send_midi_msg_press(axis_t* axis_ptr, blob_t* blob_ptr) {
  if (!axis_ptr->enabled) return;
  float t = constrain((blob_ptr->centroid.z - Z_MIN) / (float)(Z_MAX - Z_MIN), 0.0f, 1.0f);
  axis_ptr->msg.data2 = (uint8_t)roundf(axis_ptr->limit.min + t * (float)(axis_ptr->limit.max - axis_ptr->limit.min));
  if (axis_ptr->msg.data2 != axis_ptr->last_val) {
    if ((frame_now - axis_ptr->midi_time_stamp) > MIDI_THROTTLE_MS) {
      llist_push_front(&llist_midi_out, &axis_ptr->msg);
      axis_ptr->last_val = axis_ptr->msg.data2;
      axis_ptr->midi_time_stamp = frame_now;
    }
  }
};

void mapping_send_midi_msg_size(axis_t* axis_ptr, blob_t* blob_ptr) {
  if (!axis_ptr->enabled) return;
  uint16_t raw_size = (uint16_t)blob_ptr->box.w * blob_ptr->box.h;
  axis_ptr->msg.data2 = (uint8_t)constrain(
    map(raw_size, 0, BLOB_MAX_PIX, axis_ptr->limit.min, axis_ptr->limit.max),
    axis_ptr->limit.min, axis_ptr->limit.max
  );
  if (axis_ptr->msg.data2 != axis_ptr->last_val) {
    if ((frame_now - axis_ptr->midi_time_stamp) > MIDI_THROTTLE_MS) {
      llist_push_front(&llist_midi_out, &axis_ptr->msg);
      axis_ptr->last_val = axis_ptr->msg.data2;
      axis_ptr->midi_time_stamp = frame_now;
    }
  }
};

void mapping_send_midi_msg_speed(axis_t* axis_ptr, blob_t* blob_ptr) {
  if (!axis_ptr->enabled) return;
  axis_ptr->msg.data2 = (uint8_t)constrain((int)(blob_ptr->velocity.xy * 127.0f / VELOCITY_XY_MAX), 0, 127);
  if (axis_ptr->msg.data2 != axis_ptr->last_val) {
    if ((frame_now - axis_ptr->midi_time_stamp) > MIDI_THROTTLE_MS) {
      llist_push_front(&llist_midi_out, &axis_ptr->msg);
      axis_ptr->last_val = axis_ptr->msg.data2;
      axis_ptr->midi_time_stamp = frame_now;
    }
  }
};
