eTextile/Synth/Firmware/include/mapping.h

/*
  This file is part of the eTextile-Synthesizer project - https://synth.eTextile.org
  Copyright (c) 2014- Maurin Donneaud <maurin@etextile.org>
  This work is licensed under Creative Commons Attribution-ShareAlike 4.0 International license, see the LICENSE file for details.
*/

#ifndef __MAPPING_LIB_H__
#define __MAPPING_LIB_H__

#include <ArduinoJson.h>

#include "config.h"
#include "blob.h"
#include "llist.h"

#include "midi_bus.h"

typedef enum move_e {
  MOVE_LIN = 0,
  MOVE_LOG = 1,
  MOVE_ROL = 2
} move_t;

typedef enum populate_e {
  POPULATE_OFF       = 0,
  POPULATE_UP        = 1,
  POPULATE_DOWN      = 2,
  POPULATE_AS_PLAYED = 3,
  POPULATE_OCTAVE    = 4,
  POPULATE_PING_PONG = 5
} populate_t;

typedef struct point_s point_t;
struct point_s {
  float x;
  float y;
};

typedef struct rect_s rect_t;
struct rect_s {
  point_t from;
  point_t to;
};

typedef struct axis_s axis_t;
struct axis_s {
  bool enabled;
  midi_msg_t msg;
  midi_limit_t limit;
  uint16_t last_val; // 14-bit for PitchBend, 7-bit otherwise
  unsigned long int midi_time_stamp;
};

// touch_press_t  — pressure only              (switch, grid)
// touch_linear_t — 1-axis position + pressure  (slider)
// touch_planar_t — 2-axis position + pressure  (touchpad, polygon)
// All three share `press` as their first member, so a touch_press_t* cast
// is always safe for accessing pressure regardless of the concrete type.

typedef struct touch_press_s touch_press_t;
struct touch_press_s {
  axis_t press;
  axis_t speed;
};

typedef struct touch_linear_s touch_linear_t;
struct touch_linear_s {
  axis_t press;
  axis_t pos;
  axis_t speed;
};

typedef struct touch_planar_s touch_planar_t;
struct touch_planar_s {
  axis_t press;
  axis_t pos_x;
  axis_t pos_y;
  axis_t size;
  axis_t speed;
};

extern llist_t llist_mappings;

typedef struct common_s common_t;

typedef bool hardware_midi_receive_func_t(void*, midi_msg_t*);
typedef void hardware_midi_update_func_t(void*, midi_msg_t*);
typedef void hardware_midi_dispose_func_t(void*, midi_msg_t*);

typedef bool is_blob_inside_func_t(void*, blob_t*);
typedef bool blob_assign_func_t(void*, blob_t*);
typedef void blob_dispose_func_t(void*, blob_t*);

typedef void start_func_t(blob_t*);
typedef void continue_func_t(blob_t*);
typedef void stop_func_t(blob_t*);

// common_s is the vtable shared by every mapping type (slider, touchpad, switch…).
// Each mapping struct embeds common_s as its FIRST member so a (common_t*) cast is safe.
//
// Hardware MIDI input path (called by hardware_midi_io.cpp):
//   receive (mapping_ptr, msg) → bool   : return true if msg->channel matches this mapping's chan_in
//   update  (mapping_ptr, msg)           : store msg (pool node) in the mapping's active-note list
//   dispose (mapping_ptr, msg)           : decrement active count; drain pool when count reaches 0
//
// Blob lifecycle path (called by mapping_lib_update in mapping.cpp):
//   is_blob_inside (mapping_ptr, blob) → bool : true if blob centroid lies inside the mapping rect
//   blob_assign    (mapping_ptr, blob) → bool : claim next free touch slot; return false when full
//   blob_dispose   (mapping_ptr, blob)         : release touch slot; reset index when last blob lifts
//
//   start    (blob) : called once on the first frame the blob is detected (status == NEW)
//   continue (blob) : called every frame while the blob is held     (status == PRESENT)
//   stop     (blob) : called once when the blob is released          (status == RELEASED)
struct common_s {
  hardware_midi_receive_func_t* hardware_midi_receive_func_ptr;
  hardware_midi_update_func_t* hardware_midi_update_func_ptr;
  hardware_midi_dispose_func_t* hardware_midi_dispose_func_ptr;

  is_blob_inside_func_t* is_blob_inside_func_ptr;
  blob_assign_func_t* blob_assign_func_ptr;
  blob_dispose_func_t* blob_dispose_func_ptr;

  start_func_t* start_func_ptr;
  continue_func_t* continue_func_ptr;
  stop_func_t* stop_func_ptr;
};

void mapping_lib_update(void);

void mapping_send_midi_note_on(axis_t* axis_ptr, blob_t* blob_ptr);
void mapping_send_midi_note_on_xy(axis_t* axis_ptr, blob_t* blob_ptr);
void mapping_send_midi_note_off(axis_t* axis_ptr);

void mapping_send_midi_msg_pos_x(rect_t* bounding_box_ptr, axis_t* axis_ptr, blob_t* blob_ptr, move_t move = MOVE_LIN);
void mapping_send_midi_msg_pos_y(rect_t* bounding_box_ptr, axis_t* axis_ptr, blob_t* blob_ptr, move_t move = MOVE_LIN);
void mapping_send_midi_msg_press(axis_t* axis_ptr, blob_t* blob_ptr);
void mapping_send_midi_msg_size(axis_t* axis_ptr, blob_t* blob_ptr);
void mapping_send_midi_msg_speed(axis_t* axis_ptr, blob_t* blob_ptr);

#endif /*__MAPPING_LIB_H__*/
