eTextile/Synth/Firmware/include/mapp_knob.h

#ifndef __MAPPING_KNOB_H__
#define __MAPPING_KNOB_H__

#include "mapping.h"

typedef struct knob_touch_s knob_touch_t;
struct knob_touch_s {
  axis_t press;
  axis_t radius;
  axis_t theta;
  axis_t speed;
};

typedef struct knob_s knob_t;
struct knob_s {
  rect_t rect;
  point_t center;
  float radius;
  float offset;
  uint8_t touchs;
  knob_touch_t touch[MAX_KNOB_TOUCHS];
  midi_chord_t chord[MAX_KNOB_TOUCHS];
  uint8_t chan_in;
  uint8_t chan_out;
};

bool mapping_knobs_alloc(uint8_t knobs_cnt);
void mapping_knob_create(const JsonObject &config);

#endif /*__MAPPING_KNOB_H__*/
