eTextile/Synth/Firmware/include/mapp_touchpad.h

#ifndef __MAPPING_TOUCHPAD_H__
#define __MAPPING_TOUCHPAD_H__

#include "mapping.h"

typedef struct touchpad_s touchpad_t;
struct touchpad_s {
  rect_t rect;
  uint8_t touchs;
  touch_planar_t touch[MAX_TOUCHPAD_TOUCHS];
  midi_chord_t chord[MAX_TOUCHPAD_TOUCHS];
  uint8_t chan_in;
  uint8_t chan_out;
};

bool mapping_touchpads_alloc(uint8_t touchpads_cnt);
void mapping_touchpad_create(const JsonObject &config);

#endif /*__MAPPING_TOUCHPAD_H__*/
