eTextile/Synth/Firmware/include/osc_transmit.h

/*
  This file is part of the eTextile-Synthesizer project - http://synth.eTextile.org
  Copyright (c) 2014- Maurin Donneaud <maurin@etextile.org>
  This work is licensed under Creative Commons Attribution-ShareAlike 4.0 International license, see the LICENSE file for details.
*/

#ifndef __OSC_TRANSMIT_H__
#define __OSC_TRANSMIT_H__

#include "config.h"
#include "presets.h"
#include "llist.h"
#include "blob.h"

#include <OSCBoards.h>              // https://github.com/CNMAT/OSC
#include <OSCMessage.h>             // https://github.com/CNMAT/OSC
#include <OSCBundle.h>              // https://github.com/CNMAT/OSC
#include <SLIPEncodedUSBSerial.h>   // https://github.com/CNMAT/OSC

void OSC_TRANSMIT_SETUP(void);
void read_osc_input(void);
void handle_osc_input(OSCMessage &msg);
void osc_transmit(void);

#endif /*__OSC_TRANSMIT_H__*/
