eTextile/Synth/(commit log)

2021-01-04 Forked from eTextile-matrix-sensor
    [BOM_e256_teensy4_0.csv, BOM_e256_teensy4_0.xls, E256_LOGO.dxf, E256_polarity.dxf, E256_truth_table.dxf, e256_MIDI_IO.sch, e256_SGTL5000.sch, e256_annalog_IN_OUT.sch]
2021-01-05 BUGFIX with DEBUG INTERP
    [interp.cpp, scan.cpp]
2021-01-06 Added SPI for Flash MEM
2021-01-07 Minor Changes & update README
    [e256_teensy4_0.kicad_pcb]
2021-01-07 Added Warnig for missing lib Encoder2
2021-01-11 Slow down SPI to avoid nose in ADC values
    [scan.cpp]
2021-01-17 Added DELAY (micro_sc) into the scanning fonction to avoid noise betwin readings
    [scan.cpp]
2021-01-17 BUGFIX with bad limits
    [interp.cpp]
2021-01-18 Added txt regarding the board powering
2021-01-18 Changed MIDI_LEARN encoder inc did
2021-01-19 Added polyphonic synthetizer (2-track)
2021-01-22 Added median filter
2021-01-22 Added Hardware wiring diagram for MIDI IN/OUT mini-jack PLUG
2021-01-22 Added median filter and updated mapping functionalities
2021-02-02 Added demo
    [UserConfiguration.txt]
2021-02-05 Added Mapping script
    [UserConfiguration.txt]
2021-02-08 Added PCB_schematics
2021-02-08 Added schematics
2021-02-08 Renaming Synthetizer > Synthesizer
    [e256_MIDI_IO.sch, e256_SGTL5000.sch, e256_annalog_IN_OUT.sch, e256_teensy4_0.sch]
2021-02-12 BUGFIX with calibrate & LEDs
    [presets.cpp, scan.cpp]
2021-03-21 Replaced lifo with improved multy types linked list
    [blob.cpp, blob.h, config.h, interp.h, llist.cpp, llist.h, mapping.cpp, mapping.h]
2021-04-04 FIXME: MIDI include mismatch
    [config.h, mapping.cpp, mapping.h]
2021-05-14 Added teensy 3.2 support (in progress)
2021-05-16 Updated Teensy macro
2021-05-31 Updated Bounce2 INSTANTIATE A Button OBJECT
2021-06-01 Removed unused timer
2021-06-05 Added SLIP_OSC & refactoring
    [config.h, interp.cpp, interp.h, main.cpp, mapping.cpp, mapping.h, ofApp.cpp, ofApp.h]
2021-06-18 Improved Velocity & polarCoord
2021-06-22 Updated mapping & midi drivers
2021-07-02 Last FIX on circular sliders mapping ;-)
    [blob.cpp, blob.h, config.h, mapping.cpp]
2021-09-18 FIXED for MIDI I/O
    [ofApp.cpp, ofApp.h]
2021-09-19 Updated Pd driver
2021-09-26 BUGFIX with MIDI message linked list
    [blob.cpp, blob.h, config.h, mapping.cpp, mapping.h, midi_transmit.h, presets.cpp]
2021-10-02 FIX mapping_grid_populate() & mapping_grid_update()
    [blob.cpp, blob.h, config.h, llist.cpp, llist.h, mapping.cpp, mapping.h, median.cpp]
2021-10-06 CleanUp & new median filter to test
2021-10-08 BUGFIX with MIDI communication
    [blob.cpp, blob.h, config.h, mapping.cpp, midi_transmit.h, ofApp.cpp, ofApp.h, presets.cpp]
2021-10-10 BUGFIX blob percistent ID
    [blob.cpp, config.h]
2021-10-13 FUGFIX With unstable blob ID!
    [blob.cpp, config.h]
2021-11-12 USB_MTP_MIDI in progress, still Linking ERROR!
    [main.cpp, mapping.cpp, name.c]
2021-11-15 Use a custom Teensy platform variant
2021-11-16 arduinoJson & serialFlash FIXME!
    [main.cpp, mapping_lib.cpp, mapping_lib.h]
2021-11-18 mapping: add missing MAPPING_CSLIDER_SETUP function definition
    [mapping_lib.cpp]
2021-11-18 config: rework JSON config file loading
    [config.h, main.cpp, mapping_lib.cpp, mapping_lib.h]
2021-11-22 LED control refactoring
2021-12-14 Removed OSC & MTP & Added ERROR codes
    [config.cpp, config.h, main.cpp]
2021-12-14 fix config file name
    [config.cpp]
2022-01-03 BUGFIX with LEDs modes&levels
    [config.cpp, config.h, mapping_lib.cpp, median.cpp]
2022-01-08 increase MAX_BLOBS FIX Bug & cleanUp
    [blob.cpp, config.cpp, config.h, name.c]
2022-03-17 FIX Loading Mode & updated MODES
    [config.cpp, config.h, main.cpp, scan.cpp]
2025-02-26 llist: improve & fix
    * Add llist_alloc_node & llist_free_node
    * Fix llist_pop_node_front not returning head node, but next one
    * Fix llist_pop_front recycling NULL nodes to the pool
    * Fix llist_push_front & llist_push_back not checking when pool is
    exhausted
    [llist.cpp]
2025-03-01 FIX DEAD BLOBS REMOVER
    [blob.cpp]
2025-03-14 FIX: Added pressure limit to 127 for MIDI transmit
    [scan.cpp]
2025-03-17 In progress / the midi_out is not working!
    [blob.cpp, blob.h, config.h, hardware_midi_io.cpp, interp.cpp, llist.cpp, main.cpp, mapp_knob.cpp]
2025-03-31 BUG FIX in mapping.cpp : Constraint added to avoid blob and mapping association if the mapping does not accept more than the maximum number of blobs defined in the config
    [blob.cpp, config.cpp, hardware_midi_io.cpp, main.cpp, mapp_knob.cpp, mapp_polygon.cpp, mapp_slider.cpp, mapp_switch.cpp]
2025-03-31 BUG FIX in mapping.cpp : refact
    [mapp_knob.cpp, mapp_polygon.cpp, mapp_slider.cpp, mapp_switch.cpp, mapp_touchpad.cpp, mapping.cpp, mapping.h]
2025-04-07 BUGFIX with blob status
    [blob.cpp]
2025-04-08 BUGFIX with blob_cout++ placed at wrong position
    [blob.cpp]
2025-04-30 Comment Serial.printf
2025-05-20 Flip Y axis
2025-06-06 BUG FIX with the include
    [mapp_switch.cpp, mapp_touchpad.cpp, mapping.cpp, mapping.h, midi_bus.cpp, midi_bus.h]
2025-12-25 BUGFIX with switch parmas
    [mapp_knob.cpp, mapp_polygon.cpp, mapp_slider.cpp, mapp_switch.cpp, mapping.cpp]
2025-12-29 BUGFIX with MIDI params
    [config.h, llist.cpp, mapp_knob.cpp, mapp_slider.cpp, mapp_switch.cpp, mapp_touchpad.cpp, mapping.cpp, midi_bus.cpp]
2026-04-23 Update README with current project state
    - Add version, grid() TUI, all operating modes table, debug flags table
    - Document blob lifecycle, MIDI channels, key source files
    - Fix typos and switch from Arduino IDE to PlatformIO only
2026-04-23 BUGFIX MIDI filter: last_val now updated only on send, add mapp_grid
    [blob.cpp, config.cpp, config.h, hardware_midi_io.cpp, hardware_midi_io.h, interp.cpp, llist.cpp, llist.h]
2026-04-23 Fix typos: recive->receive, incomming->incoming, rescure->rescue, toucpad->touchpad
    [config.h, hardware_midi_io.cpp, hardware_midi_io.h, main.cpp, mapp_grid.cpp, mapp_grid.h, mapp_knob.cpp, mapp_knob.h]
2026-04-25 Slider: fix NoteOff via llist_push_front, avoid stack-allocated midi_msg_t
    [mapp_slider.cpp]
2026-04-25 MATRIX_INTERP_MODE: chunked SysEx transmission and loop case
2026-05-01 Blobs: SysEx layout B_COUNT=14, velocity/attack, throttle fix, Catmull-Rom interp
    blob.h: restructure blob_params_e (B_STATUS=0..B_COUNT=14), add velocity_s fields
    (attack_z, attack_done, born_at), add note_on_pending to blob_action_s
    usb_midi_io.cpp: transmit B_COUNT=14 bytes per blob; bypass throttle on NEW/FREE
    so JS never misses first-contact or last-contact events; flush once per batch
    blob.cpp: velocity & attack tracking (#ifdef VELOCITY); EMA-smoothed xy/z speed;
    peak-drop attack detection for deferred NoteOn
    mapping.cpp: deferred NoteOn via note_on_pending; mapping_flush_pending_note_on()
    interp.cpp: replace bilinear with Catmull-Rom bicubic; pre-computed weight table
    mapp_grid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
    [blob.cpp, blob.h, config.h, interp.cpp, mapp_grid.cpp, mapp_slider.cpp, mapp_switch.cpp, mapp_touchpad.cpp]
2026-05-02 Mappings: receive_chan→input_chan, JSON key "receive"→"input_chan", midi_{receive,dispose,update}→hardware_midi_*
2026-05-02 Blob: xy velocity (1ms), note_on_z/xy_pending, mapping_flush_pending_note_on_xy; VELOCITY→BLOB_VELOCITY; rename midi_*→midi_hardware_* typedefs/func_ptrs; bootTime→boot_time
2026-05-02 Cleanup: drop // TESTING! markers, rename midi_hardware_receive_func_ptr typedef→_t, remove dead commented blocks
2026-05-02 mapp_slider: wrap switch cases in braces to fix cross-initialization compile errors
    [mapp_slider.cpp]
2026-05-02 ROL slider: fix NoteOn velocity=0 on placement and step crossings
    Initial finger placement uses note_on_z_pending (z-attack) instead of
    note_on_xy_pending, because xy velocity is ~0 when the finger first lands.
    Step-crossing NoteOns in mapping_send_midi_note_on_xy() now floor data2 to
    at least 1 so a very slow slide cannot produce a velocity=0 NoteOff.
    [mapp_slider.cpp, mapping.cpp]
2026-05-02 Slider: harmonize NoteOn/NoteOff logic; fix e256_m array size
    - start(): call mapping_send_midi_note_on() for all NoteOn cases (ROL and
    non-ROL) — removes manual type+pending duplication; the helper already
    handles z-attack deferral
    - continue() ROL: guard NoteOff+NoteOn step crossing with !note_on_z_pending;
    if initial NoteOn not yet sent, only retarget data1 to avoid orphan NoteOff
    - stop(): cancel note_on_z_pending instead of sending NoteOff when the initial
    NoteOn was never sent (blob released before attack window closed)
    - config.cpp: fix e256_m[] declared [16] but holding 17 entries (0..16)
    [config.cpp, mapp_slider.cpp]
2026-05-02 Vz display: use VELOCITY_Z_DISPLAY_MAX (500) instead of VELOCITY_ATTACK_Z_MAX (4000)
    VELOCITY_ATTACK_Z_MAX is calibrated for NoteOn attack — too large for the
    blob SysEx display. Typical press velocities (100–500 units/s) encoded with
    /4000 barely deviate from 64. New VELOCITY_Z_DISPLAY_MAX = 500 gives visible
    changes across the normal press range (full scale at ~500 units/s).
    [config.h]
2026-05-02 ROL slider: use xy velocity for initial NoteOn, fix deferred flush guard
    - mapping_flush_pending_note_on_xy: wait for velocity.xy ≥ 1.0 or age ≥
    VELOCITY_ATTACK_MAX_MS instead of firing on first PRESENT frame (which
    had velocity.xy=0 and would produce a NoteOff-disguised NoteOn)
    - mapp_slider start(): separate ROL + NoteOn branch that sets
    note_on_xy_pending so the NoteOn velocity reflects lateral slide speed
    - mapp_slider continue/stop(): widen pending guard to cover both flags so
    no orphan NoteOff is sent while a deferred NoteOn is still pending
    [mapp_slider.cpp, mapping.cpp]
2026-05-03 Firmware: tap_tempo, HW MIDI channel from config, EMA smoothing, scan optimizations, encoder fix
    - Switch: add tap_tempo mode (TimingClock at tapped BPM), parse tap_tempo from JSON config
    - midi_seq: implement tap_tempo_hit() circular buffer + tap_tempo_clock_tick() called from mapping_lib_update()
    - hardware_midi_io: hardware_midi_input_channel runtime-configurable via hardware_midi_set_input_channel()
    - config: parse global.hardware_midi_input_channel from JSON, include hardware_midi_io.h
    - median: replace broken insertion-sort with EMA (alpha=0.3), seed on NEW blob
    - scan: static ADC, digitalWriteFast, extract spi_select_cell/discharge_and_sample helpers
    - config: fix read_encoder() — u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
    [blob.cpp, blob.h, config.cpp, config.h, hardware_midi_io.cpp, hardware_midi_io.h, mapp_slider.cpp, mapp_switch.cpp]
2026-05-03 Docs: correct Hardware_electronic and Hardware_textile READMEs
    - Hardware_electronic: fix Button D1 long press description (save to flash),
    rewrite MIDI LEARN section as TODO with accurate planned behaviour
    - Hardware_textile: fix heading hierarchy, typos (identicals→identical,
    bounding→bonding, antena→antenna, Silicon→silicone), update Python 2
    install commands to Python 3, move SVG file out of BOM into its own section
2026-05-04 Firmware: fix slider 2-touch off-by-one, zero-copy HW MIDI input, USB MIDI fixes
    - mapp_slider: fix < → <= in touch-count guards so touchs==MAX_SLIDER_TOUCHS
    (2) no longer silently skips llist_mappings registration; same fix in
    mapping_sliders_alloc for the pool allocation guard
    - hardware_midi_io: zero-copy refactor — defer pool alloc to NoteOn-match path
    only; dispose() path uses stack pointer (safe, confirmed dispose doesn't store)
    - hardware_midi_io / usb_midi_io: MIDI.sendClock() / usbMIDI.sendClock() replace
    removed sendRealTime(midi::TimingClock) API
    - usb_midi_io: replace raw while(usbMIDI.read()) drain with usb_midi_receive()
    so incoming PC mode-change messages are not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
    [config.cpp, config.h, hardware_midi_io.cpp, hardware_midi_io.h, main.cpp, mapp_slider.cpp, mapp_switch.cpp, mapping.cpp]
2026-05-04 Firmware: fix off-by-one in all mapping alloc/create touch guards (< → <=)
    Same bug as the slider fix: using strict < against MAX_*_TOUCHS caused
    mappings configured at the maximum touch count to never be registered in
    llist_mappings. Fixed in touchpad, switch, knob, polygon, grid (alloc
    and create guards).
    [mapp_grid.cpp, mapp_knob.cpp, mapp_polygon.cpp, mapp_switch.cpp, mapp_touchpad.cpp]
2026-05-04 Firmware: fix MIDI pool leaks in usb_read_* and THROUGH_MODE drain
    - usb_read_note_on/off/cc/aftertouch/pitchbend: move pool allocation
    inside THROUGH_MODE guard — in other modes no node is allocated so
    there is nothing to leak (previously a node was always popped then
    silently dropped when not in THROUGH_MODE)
    - main.cpp: declare midi_msg_ptr at top of loop() so it is in scope
    for the THROUGH_MODE case; THROUGH_MODE drain now returns each node
    to llist_midi_nodes_pool after transmission; end-of-frame drain kept
    as safety net for PLAY/STANDALONE static-pointer entries (not pool
    nodes, must not be returned)
    [main.cpp]
2026-05-04 Refactor: rename Pi constants, touch types, fix knob casts, document common_t
    - config.h: IIPi→TWO_PI, IIIPiII→THREE_PI_OVER_2, PiII→PI_OVER_2
    - mapping.h: touch_1d_t→touch_press_t (press only — switch, grid, polygon),
    touch_2d_t→touch_linear_t (pos+press — slider),
    touch_3d_t→touch_planar_t (pos_x+pos_y+press — touchpad, polygon);
    add explanatory comment above type definitions; document common_t
    vtable contracts (receive/update/dispose, is_inside/assign/dispose,
    start/continue/stop) with preconditions and semantics
    - mapp_knob.cpp: fix mapping_knob_start/stop using touch_3d_t* cast
    (worked by coincidence — press is first field in both) → knob_touch_t*
    - mai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
    [config.h, main.cpp, mapp_grid.cpp, mapp_grid.h, mapp_knob.cpp, mapp_others.cpp, mapp_polygon.cpp, mapp_polygon.h]
2026-05-04 Docs: update Firmware README for recent changes
    - Boot: PENDING_MODE now falls through to PLAY_MODE (not STANDALONE_MODE)
    - Velocity constants: EMA_ALPHA 0.3→0.4, ATTACK_Z_MAX 4000→1500,
    add VELOCITY_XY_MAX row
    - TUI table: add Notes column, document tap_tempo switch option and
    slider step zones
    - Key source files: add midi_tap_tempo.cpp, mapping.h touch types
2026-05-06 Harmonize: align struct style, pool naming, indentation, remove stale comments
    - switch, polygon: remove unnecessary forward struct declaration
    - switch: rename llist_switch_pool → llist_switchs_pool (matches plural pattern)
    - touchpad, grid: fix is_blob_inside continuation indent (8→6 sp) + drop blank line
    - switch, touchpad, knob, grid, polygon: remove // IN PROGRESS! markers
    - polygon: drop dead MidiType press field from mapp_polygon_s (params.press is used)
    - polygon: fix spurious }; → } in dispose_blob, fix break/default indent in stop
    [mapp_grid.cpp, mapp_knob.cpp, mapp_polygon.cpp, mapp_switch.cpp, mapp_touchpad.cpp]
2026-05-07 Fix: blob dispatch crash and vertical slider inversion
    - mapping.cpp: guard dispatch with assigned==mapping_ptr to prevent
    wrong mapping's stop_func being called on a foreign blob (crash)
    - mapp_slider.cpp: invert Y rect for vertical slider so bottom=0, top=127
    [mapp_slider.cpp, mapping.cpp]
2026-05-07 Fix: grid key_id out-of-bounds crash and key tracking logic
    lround() near grid edges could return cols/rows, indexing key[] past its
    bounds. key_x/key_y are now clamped to [0, cols-1] / [0, rows-1].
    Also fixed: last_val was saved before key_id was computed (always 0),
    continue never sent NoteOff on key change, stop sent NoteOff via the
    uninitialized touch slot instead of the active key slot.
    [mapp_grid.cpp]
2026-05-07 Fix: SFF null-deref crash and enlarge context/node pools
    llist_pop_front() was dereferenced before the NULL check at two push-up
    and one push-down sites in the SFF, crashing if llist_context_pool ran
    out. Added early-exit guards (if !context break) before any field access.
    Also moved the redundant null check at the pop-and-restore site to match.
    LIFO_NODES 1024→2048: multi-finger blobs with complex topology can exceed
    1024 simultaneous pending scanlines, exhausting the context pool.
    LLIST_NODES_POOL 2000→3000: covers the larger context pool plus headroom
    for future growth. Teensy 4.0 has 512KB RAM so cost is negligible.
    [blob.cpp, llist.cpp]
2026-05-08 Fix: SFF OOB crash at bottom edge and oversized blob freeze
    - Guard down-scan with posY < NEW_ROWS-1 to prevent reading/writing
    past the end of interp_frame and bitmap buffers when a blob touches
    the last row (posY=63), which was cascading into lifo_array memory
    - Add BLOB_MAX_PIX early exit in while_A to drain llist_context and
    break immediately when blob is already too large, preventing the SFF
    from scanning thousands of phantom pixels in OOB memory
    - Cap posX to NEW_COLS-1 at the top of while_A to prevent column OOB
    when the push block sets posX = i++ with i == NEW_COLS-1
    - Mark pixel in bitmap on context pool exhaustion to prevent the same
    pixel being re-found on subsequent f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
    [blob.cpp, config.h]
2026-05-08 Fix: clamp blob UID to 7-bit range and prioritize RELEASED events
    MIDI SysEx data bytes must be 0-127; UID counter wrapped at 256,
    causing any UID >= 128 to corrupt the SysEx message and prevent
    the blob from displaying in the web app.
    - blob.cpp: UID counter now wraps at 128 (& 0x7F)
    - usb_midi_io.cpp: RELEASED added to is_event so cleanup messages
    bypass the throttle and are always delivered promptly to the host
    [blob.cpp]
2026-05-15 Fix: clear llist_mappings before applying new config to prevent duplicates
    - Clear llist_mappings at the start of mappings_load_config so repeated
    UPLOAD→APPLY cycles don't accumulate duplicate mapping entries; each
    llist_pop_front returns the node to the pool (no memory leak)
    - Add turnThruOff() and while(HARDWARE_MIDI.read()) to fix hardware MIDI
    IN callback not triggering when a keyboard is connected
    - Various firmware and hardware updates
    [e256_teensy4_0.kicad_pcb]
2026-05-15 Fix: knob offset degrees-to-radians conversion and wrong press axis pointer
    - Convert params.offset from degrees to radians before passing to cos()/sin()
    - Fix mapping_send_midi_msg_press call to use touch_ptr->press instead of touch_ptr->theta
    [mapp_knob.cpp]
2026-05-17 Firmware: polygon distance-to-vertex MIDI + new touch_polygon_t struct
    - Add touch_polygon_t with axis_t press + axis_t source[MAX_POLYGON_POINTS]
    - Replace touch_planar_t in polygon_s with touch_polygon_t
    - Add max_dist field (precomputed bounding-box diagonal)
    - mapping_polygon_continue: compute Euclidean distance blob→vertex per touch,
    map to MIDI CC (close=max, far=min), throttled via MIDI_THROTTLE_MS
    - mapping_polygon_create: read config["segments"][i][0/1] instead of
    config["cnt"]/config["point"][i]["X"/"Y"]; read per-touch source_N axes
    - mapping_polygon_start/stop: update casts to touch_polygon_t*
    [mapp_polygon.cpp, mapp_polygon.h]
2026-05-18 Fix: SysEx protocol migration, UPLOAD deadlock, and misc mapping fixes
    - Replace all ProgramChange mode-switch calls with SysEx commands (usb_midi_io, main, config)
    - Fix UPLOAD CONFIG deadlock on Teensy 4.x: single-callback delivery for large JSON was
    never handled — now uses `complete && sysEx_chunk_count == 0` guard with exact data length
    - Add SysEx ACK/ERR/param helpers (usb_midi_send_sysex_ack, usb_midi_send_sysex_err, usb_midi_send_sysex_param)
    - Fix switch/touchpad MIDI send to use correct linked-list iteration
    - Fix slider/grid mapping send calls
    - Add RAW_COLS/RAW_ROWS/INTERP_COLS/INTERP_ROWS constants to config.h
    [config.cpp, config.h, hardware_midi_io.cpp, main.cpp, mapp_grid.cpp, mapp_knob.cpp, mapp_polygon.cpp, mapp_slider.cpp]
2026-05-18 Docs: update README — SysEx protocol, boot sequence, mode table
    - Config Upload Protocol: replace obsolete ProgramChange description
    with accurate SysEx handshake (CMD/ACK/ERR/PARAM packet types)
    - Boot sequence: fix — app goes to MATRIX_RAW after SYNC, not CONFIG_FILE_REQUEST
    - Mode table: add MATRIX_INTERP_MODE (was missing)
    - MIDI Channels: replace channel table with SysEx packet type table;
    clarify that standard MIDI channels are for user TUI mappings only
2026-05-21 Fix: guard press JSON parsing against None/Chord modes in switch and touchpad
    mapp_switch.cpp and mapp_touchpad.cpp unconditionally accessed
    press.midi fields, crashing when press mode is None (0xFF) or
    Chord (0xFE) — neither exports a midi key in the JSON.
    Apply the same switch(params.press) pattern already used by
    mapp_knob.cpp and mapp_slider.cpp: only read midi/limit fields
    for NoteOn, ControlChange, AfterTouchPoly; skip for all others.
    [mapp_switch.cpp, mapp_touchpad.cpp]
2026-05-21 Feat: implement Chord press mode in firmware (switch + touchpad)
    - midi_bus.h/cpp: add midi_chord_t struct, MIDI_TYPE_CHORD sentinel (0xFE),
    chord interval table (Major/Minor/Dim/Aug/Maj7/Min7/Dom7/Sus2/Sus4),
    midi_send_chord_on/off — sends NoteOn/Off for all chord tones from
    pre-allocated per-touch msg arrays (no heap, no pool usage)
    - mapp_switch/touchpad .h: add chord[] array to params struct
    - mapp_switch/touchpad .cpp: add chord_notes[][] to internal mapping struct;
    parse chord.type + chord.note from JSON; start() sends chord NoteOn,
    stop() sends chord NoteOff
2026-05-21 Refactor: move ti calculation inside MIDI_TYPE_CHORD case only
2026-05-22 Refactor: fix remaining type* pointer style in mapp_others.cpp
    [mapp_others.cpp]
2026-05-22 Refactor: replace tap_tempo bool with press == Clock check in switch mapping
    [config.cpp, hardware_midi_io.cpp, mapp_switch.cpp, mapp_switch.h]
2026-05-22 Refactor: split input_chan into chan_in/chan_out in all mapping structs
    JSON key changes from "input_chan": N to "chan": {"in": N, "out": N}.
    chan_in used for hardware MIDI input filtering, chan_out for MIDI output (chord notes).
2026-05-22 Fix: defer boot config USB sysex to SYNC handler — silent in STANDALONE mode
    In setup(), store config load result in boot_config_ack/err instead of
    sending immediately. Send deferred notification only when a USB host
    connects and sends SYNC — never fires in STANDALONE mode.
    [main.cpp]
2026-05-22 Fix: guard usb_midi_send_sysex_param in read_encoder against STANDALONE mode
    [config.cpp]
2026-05-22 Optim: eliminate sqrtf/pow in blob distance, use integer centroid accumulators, break after blob assign
    - blob.cpp: is_blob_existing — replace sqrtf(pow(...)) with dx*dx+dy*dy < dist² (no transcendental calls)
    - blob.cpp: float blob_cx/cy → uint32_t + uint16_t sum (integer accumulation, single float divide at end)
    - mapping.cpp: break inner blob loop after first successful assign (prevents redundant iterations)
    [blob.cpp, mapping.cpp]
2026-05-22 Optim: separable Catmull-Rom — halve FP multiplications in matrix_interp
    Pre-compute row_sums[SCALE_Y][4] = Σ_dy w_y * nb[dy][dx] (phase 1, 64 mults),
    then apply X weights per output pixel (phase 2, 64 mults).
    Total: 128 mults/cell vs 256 — exactly 2× reduction on the hottest loop.
    Also: remove dead out_row/out_col bounds checks (values always in range by
    construction), hoist out_row*NEW_COLS into a row pointer per ky, and replace
    lroundf(val) with (int)(val+0.5f) to eliminate the library call from the inner loop.
    [interp.cpp]
2026-05-22 Optim: snapshot millis() once per frame in mapping_lib_update
    Replaces the 6 redundant millis() calls (2 per throttle function × 3 functions)
    with a single frame_now snapshot taken at the top of mapping_lib_update().
    Each active blob no longer pays a syscall on every pos_x, pos_y, and press update.
    [mapping.cpp]
2026-05-22 Fix: remove boot_config_ack — silent success, only errors notified at SYNC
    boot_config_ack sent CONFIG_APPLY_DONE (value=13) at SYNC time, which the JS
    misread as APPLY_CONFIG (same value) and switched to EDIT mode on every connect.
    A successful flash config load at boot needs no notification: the firmware is
    ready and the JS reaches EDIT mode through normal user navigation. Only errors
    (CONFIG_FILE_MISSING, CONFIG_APPLY_FAILED) still notify via boot_config_err.
    [main.cpp]
2026-05-22 Feat: add MIDI_TYPE_CHORD support to knob mapping
    knob_t gains chord[MAX_KNOB_TOUCHS] params; mapp_knob_t gains chord_notes[][].
    mapping_knob_start/stop handle MIDI_TYPE_CHORD with midi_send_chord_on/off,
    mapping_knob_create parses chord.type and chord.note from JSON config.
    Mirrors the existing switch and touchpad chord implementations.
2026-05-23 Feat: send TOO_MANY_TOUCHS SysEx error when config exceeds firmware limits
    Adds TOO_MANY_TOUCHS to error_code_t and fires usb_midi_send_sysex_err()
    in each mapping's config loader when params.touchs > MAX_*_TOUCHS.
    [config.cpp, config.h, mapp_knob.cpp, mapp_slider.cpp, mapp_switch.cpp, mapp_touchpad.cpp]
2026-05-24 Doc: replace resistive_pressure_sensors.odt with reviewed Markdown
    Remove binary .odt source and generated .md.xml index; add clean .md
    with corrected terminology, improved ASCII diagrams, and publication-ready prose.
2026-05-24 Fix: hardware MIDI_IN — add CC/AfterTouch handlers, remove reentrant read
    - Add setHandleControlChange and setHandleAfterTouchPoly callbacks
    - Remove while(usbMIDI.read()) from hardware_midi_forward_input (reentrant, corrupts USB MIDI state)
    - Remove while(HARDWARE_MIDI.read()) from mapping_hardware_midi_transmit (redundant double-drain)
    [hardware_midi_io.cpp]
2026-05-24 Feat: forward hardware MIDI IN to web as SysEx SYSEX_PKT_MIDI_IN (0x05)
    Replaces raw usbMIDI.send() with a SysEx packet so the browser can
    distinguish hardware MIDI IN from sensor-generated MIDI and route it
    to the E256-IN terminal column.
    Packet layout: F0 DEVICE_ID 0x05 type_nibble channel_0based data1 data2 F7
    [config.h, hardware_midi_io.cpp]
2026-05-25 Docs: update Hardware_textile README and resistive pressure sensors doc
    - Add E256_path_02.svg note (experimental, WIP) to README CUTTING PATTERN section
    - Add piezo_resistive.png image inline between conductive layers in resistive_pressure_sensors.md
    - Tighten diagram spacing and remove extra blank lines
2026-05-25 Feat: update Processing MIDI sketch & remove obsolete software
    - Update SYNTH_MIDI_java to new SysEx blob protocol (B_COUNT=14 fields)
    - Fix thread safety with synchronized HashMap + draw() snapshot
    - Fix port name and SysexMessage sending via javax.sound.midi API
    - Remove obsolete: MaxMSP patches, Ableton Live config, OSC p5 sketch, Python usb_config
    - Update resistive_pressure_sensors.md diagram spacing
    [UserConfiguration.txt]
2026-05-25 Feat: implement MOVE_LOG curve and tune VELOCITY_XY_MAX
    - Add move_t default param to mapping_send_midi_msg_pos_x/y (MOVE_LIN keeps existing behaviour)
    - Implement logarithmic position curve (logf) for MOVE_LOG in both pos_x and pos_y
    - Pass slider params.move to pos_x/y calls so LIN/LOG are respected per mapping
    - Lower VELOCITY_XY_MAX from 200 to 120 so MIDI 127 is reached at a slower lateral speed
2026-05-26 Fix: read slider dir from JSON field, fallback to aspect ratio
    Read dir (0=VERTICAL, 1=HORIZONTAL) explicitly from the JSON config when
    present, so uploads from the updated web app set direction deterministically.
    Falls back to bounding-box aspect ratio for configs predating the dir field.
    Direction detection moved outside the touch loop where it belongs.
    [mapp_slider.cpp]
2026-06-02 Feat/Fix: slot recycling, blob SysEx trim, PLAY mode blob transmission
    Touch slot recycling (touchpad, slider, knob):
    - Replace touch_index (monotonically increasing) with slot_mask bitmask
    - assign_blob: scan for first free bit → freed slots recycled immediately
    - dispose_blob: clear bit via pointer arithmetic, no full reset needed
    - Fixes "lifted finger has no effect" when all slots were previously occupied
    - _create() zeroes slot_mask + active_blob_count to avoid stale state on reload
    Blob SysEx packet (blob.h, usb_midi_io.cpp):
    - Remove B_VELOCITY_Z (index 11) — dual-phase encoding was complex, unused
    - Remove B_ATTACK_DONE (index 13) — frontend derives this from ATTACK_Z value
    -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
    [blob.h, config.h, main.cpp, mapp_knob.cpp, mapp_slider.cpp, mapp_touchpad.cpp, mapping.cpp, mapping.h]
2026-06-03 Fix: axis enabled flag derived from MIDI status byte, not absent JSON field
    Replace `config[...]["enabled"] | true` (ArduinoJson default=true when key
    missing) with `(status_byte != 0)` across all mapping types. The JS never
    writes an "enabled" field, so every axis was always enabled regardless of
    configuration — causing unconfigured CC axes to send spurious MIDI messages.
    Affected: mapp_touchpad (pos_x, pos_y, size, press), mapp_slider (pos, press),
    mapp_knob (radius, theta, press), mapp_switch (press), mapp_polygon (press,
    source_N). Default case in press switch now explicitly sets enabled=false.
    [mapp_knob.cpp, mapp_polygon.cpp, mapp_slider.cpp, mapp_switch.cpp, mapp_touchpad.cpp]
2026-06-07 Feat/Fix: grid mapping fully wired, chord hysteresis, Wicki-Hayden layout
    - config.cpp: load grid mappings from JSON (was missing entirely)
    - mapp_grid.cpp: fix touchs fallback, scale factors as float, floor-based
    key detection, 25% hysteresis in continue to prevent chord oscillation
    at cell boundaries
    - General mapping refactor across all mapping types
    [blob.cpp, blob.h, config.cpp, config.h, interp.cpp, main.cpp, mapp_grid.cpp, mapp_grid.h]
2026-06-13 Fix: TOUCH_SLOT_NONE 0xFF→0x7F to keep SysEx data in 7-bit range
    0xFF in a SysEx data byte is interpreted as MIDI System Reset,
    corrupting the MIDI stream and breaking all USB MIDI communication.
    0x7F is the max valid SysEx data byte and a safe unassigned sentinel.
    [blob.h]
2026-06-13 Fix: default THRESHOLD level value 5→2
    [config.cpp]
2026-06-15 Perf/Fix: selective interp clear, threshold offset constant, note_on_only grid flag
    - interp.cpp: replace full memset(4096B) with clear_prev_active_cells() — only
    zeroes the 4×4 output blocks that were written last frame (bitmask per row);
    rename magic offset 4→INTERP_THRESHOLD_OFFSET=1 to match default threshold=2
    - mapp_grid.cpp: add note_on_only[] flag per key — suppresses NoteOff on release
    (Trigger mode), read from JSON field press.note_on_only
    - docs/index.html: fix missing closing quote on GitHub href
    [interp.cpp, mapp_grid.cpp]
2026-06-16 Refactor: SYNTH_MIDI.pd — SysEx mode commands via midiout
    Replace pgmout (Program Change) with raw SysEx via midiout:
    [0xF0 0x7D 0x01 mode 0xF7] — port set at load via loadbang.
    Add CALIBRATE(2), MATRIX_RAW(3), MATRIX_INTERP(4) buttons.
    Fix Calibrate value was 3 (MATRIX_RAW) → now 2 (CALIBRATE_MODE).
2026-06-16 Feat: SuperCollider live granular synthesis patch (e256_granular.sc)
    Records live audio into an 8s ring buffer, reads it with TGrains.
    All granular parameters addressable via MIDI CC (see CC map in header):
    CC1 duration, CC2 density, CC3 rate/pitch, CC4 position, CC5 pos-scatter,
    CC6 rate-scatter, CC7 pan, CC8 amp, CC11 dry/wet, CC12 feedback,
    CC64 freeze, CC71 filter-res, CC74 filter-cutoff.
2026-06-17 Feat: adapt e256_granular.sc for Bela standalone deployment
    - Add Bela server options (blockSize=16, analog/digital channels)
    - Replace outer () wrapper with top-level script + ServerQuit.add
    - Connect to ETEXTILE_SYNTH USB MIDI and send USB_INTERFACE_MODE SysEx on boot
    - Guard MIDI init against missing device (graceful degradation)
    - Fix var declaration order in SynthDef (SuperCollider syntax requirement)
2026-06-17 Fix: USB_INTERFACE_MODE transmits mappings via USB, not hardware MIDI
    [main.cpp]
2026-06-17 Fix: PENDING_MODE timeout switches to STANDALONE_MODE, not PLAY_MODE
2026-06-17 Docs: reorganise modes — STANDALONE+USB_INTERFACE as performance, THROUGH+PLAY as utility
2026-06-17 Docs: remove DAW mention from utility modes — DAW use requires USB_INTERFACE_MODE
2026-06-17 Docs: fix grid() key modes — Note gate / Note trigger / Chord
2026-06-18 Fix: copy flash config into sysEx_data at boot so long-press LEFT can re-save without web-app upload
    sysEx_data_length was 0 after every firmware reflash/power cycle, making
    the long-press save silently do nothing until a full web-app upload cycle
    was completed. Boot now copies flash_config_ptr into a separate sysEx_data
    buffer (safe against ALLOCATE_MODE realloc).
    [main.cpp]
2026-06-18 Fix: STANDALONE_MODE now polls usb_midi_receive so web app / SC can exit it
    Without this, any USB mode command (SYNC, USB_INTERFACE_MODE, etc.) was
    silently ignored once the device transitioned to STANDALONE_MODE, making
    the web app unable to sync and SuperCollider unable to get an ACK.
    [main.cpp]
2026-06-18 Revert: STANDALONE_MODE must not use USB — revert usb_midi_receive addition
    STANDALONE_MODE is USB-free by design. The PENDING_MODE timeout (already
    5 s in config.h) gives the web app time to send SYNC before the device
    goes standalone. Fix README to say 5 s instead of 4 s.
    [main.cpp]
2026-06-23 Feat/Rename/Fix: move→speed, PitchBend 14-bit, LICENSE, Bela Granular
    Renames:
    - axis_t.move → axis_t.speed in touch structs (mapp_knob, mapp_polygon headers)
    - mapping_send_midi_msg_move → mapping_send_midi_msg_speed
    - config["msg"][i]["move"] → config["msg"][i]["speed"] in all mapping sources
    - Preserved slider params.move (LIN/LOG/ROL algorithm, separate from touch velocity)
    Feat: PitchBend 14-bit resolution in mapping_send_midi_msg_pos_x/y
    - axis_t.last_val: uint8_t → uint16_t to track 14-bit values
    - _pos_to_val() helper: PitchBend splits value into data1 (LSB) + data2 (MSB)
    - Scaling: limit 0-127 → 0-16383 via × 129 (127 × 129 = 16383 exact)
    - All other MIDI types unchan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
    [config.cpp, config.h, mapp_knob.cpp, mapp_knob.h, mapp_polygon.cpp, mapp_polygon.h, mapp_slider.cpp, mapp_switch.cpp]
2026-06-26 Feat/Rename/Fix: move→speed, PitchBend 14-bit, LICENSE, Bela Granular
    Split MIDI_TYPE_CHORD into CHORD_TRIGGER (0xFE, no note-off) and
    CHORD_GATE (0xFD, note-off on release) across grid, knob, switch and
    touchpad mappings. Config field "gate": true selects CHORD_GATE.
    [mapp_grid.cpp, mapp_knob.cpp, mapp_switch.cpp, mapp_touchpad.cpp, midi_bus.h]
2026-07-01 Feat: add BOOTLOADER_MODE (18) — triggers HalfKay via SysEx for OTA flash
    Firmware reboots immediately into the HalfKay USB bootloader on receiving
    this command. No ACK is sent (device disconnects before it could be sent).
    The web app should switch from Web MIDI to WebHID after sending the command.
    [config.cpp, config.h]
